piecol/MIRA/nextpcb/MIRA_BOM_1.xlsx

Designator | MPN | Quantity | Value | Footprint | LCSC | Manufacturer | Description | Product link
L8 | LQW15AN68NG00D | 1 | 68nH | Inductor_SMD:L_0402_1005Metric | C108965 | Murata Electronics | 1.96Ω 140mA 68nH Unshielded Inductor ±2% 0402 Power Inductors ROHS | https://jlcpcb.com/partdetail/MurataElectronics-LQW15AN68NG00D/C108965
L9 | LQW15AN9N1G00D | 1 | 9.1nH | Inductor_SMD:L_0402_1005Metric | C113122 | Murata Electronics | 140mΩ 25@250MHz 5.5GHz 540mA 9.1nH ±2% 0402 Inductors (SMD) ROHS | https://jlcpcb.com/partdetail/MurataElectronics-LQW15AN9N1G00D/C113122
R7,R11,R12,R21,R35,R36 | 0402WGF1001TCE | 6 | 1k | Resistor_SMD:R_0402_1005Metric | C11702 | UNI-ROYAL(Uniroyal Elec) | -55℃~+155℃ 1kΩ 50V 62.5mW Thick Film Resistor ±1% ±100ppm/℃ 0402 Chip Resistor - Surface Mount ROHS | https://jlcpcb.com/partdetail/12256-0402WGF1001TCE/C11702
U10 | RFANT3216120A5T | 1 | RFANT3216120A5T | EasyEDA:FILTER-SMD_1206-2P-L3.2-W1.6-L | C127629 | Walsin Tech Corp | -40℃~+85℃ 1.2mm 1.55mm 1.6mm 100MHz 2 2.4GHz 2dBi 3.2mm 1206 Antennas ROHS | https://jlcpcb.com/partdetail/Walsin_TechCorp-RFANT3216120A5T/C127629
Q1 | AO3401A | 1 | AO3401A | Package_TO_SOT_SMD:SOT-23 | C15127 | Alpha & Omega Semicon | 1 P-Channel 14nC@10V 30V 47mΩ@10V、60mΩ@4.5V、85mΩ@2.5V 4A 55pF 645pF 80pF 900mV SOT-23 MOSFETs ROHS | https://jlcpcb.com/partdetail/Alpha_OmegaSemicon-AO3401A/C15127
U11 | LIS3DHTR | 1 | LIS3DH | Package_LGA:LGA-16_3x3mm_P0.5mm_LayoutBorder3x5y | C15134 | STMicroelectronics | -40℃~+85℃ 1.71V~3.6V 16bit 500nA Accelerometer Motion event detection SPI、I2C X,Y,Z ±16g LGA-16(3x3) Accelerometers ROHS | https://jlcpcb.com/partdetail/STMicroelectronics-LIS3DHTR/C15134
Q2,Q4 | DMN2990UFA-7B | 2 | DMN2990UFA-7B | EasyEDA:XFDFN-3_L0.8-W0.6-P0.35-BR | C151598 | Diodes Incorporated | -55℃~+150℃ 1 N-channel 1V 2.4Ω@1.5V 20V 400mW 5.6pF 510mA 55.2pF 8pF N-Channel XFDFN-3(0.6x0.8) MOSFETs ROHS | https://jlcpcb.com/partdetail/DiodesIncorporated-DMN2990UFA7B/C151598
U2 | TPS63900DSKR | 1 | TPS63900 | Package_SON:WSON-10-1EP_2.5x2.5mm_P0.5mm_EP1.2x2mm_ThermalVias | C1518762 | Texas Instruments | -40℃~+125℃@(TJ) 1 1.8V~5.5V 1.8V~5V 400mA 75nA Adjustable Buck-Boost Buck-Boost Built-in Overcurrent Protection、Adjustable current limiting、Dynamic voltage scaling Yes WSON-10-EP(2.5x2.5) DC-DC Converters ROHS | https://jlcpcb.com/partdetail/TexasInstruments-TPS63900DSKR/C1518762
C47 | CL05B103KB5NNNC | 1 | 10n | Capacitor_SMD:C_0402_1005Metric | C15195 | Samsung Electro-Mechanics | 10nF 50V X7R ±10% 0402 Multilayer Ceramic Capacitors MLCC - SMD/SMT ROHS | https://jlcpcb.com/partdetail/15869-CL05B103KB5NNNC/C15195
C3,C5,C28,C32,C34,C36,C39,C44,C45,C46 | CL05B104KO5NNNC | 10 | 100n | Capacitor_SMD:C_0402_1005Metric | C1525 | Samsung Electro-Mechanics | 100nF 16V X7R ±10% 0402 Multilayer Ceramic Capacitors MLCC - SMD/SMT ROHS | https://jlcpcb.com/partdetail/1877-CL05B104KO5NNNC/C1525
C27 | 0402CG150J500NT | 1 | 15p | Capacitor_SMD:C_0402_1005Metric | C1548 | FH (Guangdong Fenghua Advanced Tech) | 15pF 50V C0G ±5% 0402 Multilayer Ceramic Capacitors MLCC - SMD/SMT ROHS | https://jlcpcb.com/partdetail/1900-0402CG150J500NT/C1548
C6,C7,C12,C30,C50 | CL05A106MQ5NUNC | 5 | 10u | Capacitor_SMD:C_0402_1005Metric | C15525 | Samsung Electro-Mechanics | 10uF 6.3V X5R ±20% 0402 Multilayer Ceramic Capacitors MLCC - SMD/SMT ROHS | https://jlcpcb.com/partdetail/16204-CL05A106MQ5NUNC/C15525
C35,C37 | 0402CG390J500NT | 2 | 39p | Capacitor_SMD:C_0402_1005Metric | C1563 | FH (Guangdong Fenghua Advanced Tech) | 39pF 50V C0G ±5% 0402 Multilayer Ceramic Capacitors MLCC - SMD/SMT ROHS | https://jlcpcb.com/partdetail/1915-0402CG390J500NT/C1563
C21 | GRM0335C1E180GA01D | 1 | 18p | Capacitor_SMD:C_0201_0603Metric | C161374 | Murata Electronics | 18pF 25V C0G ±2% 0201 Multilayer Ceramic Capacitors MLCC - SMD/SMT ROHS | https://jlcpcb.com/partdetail/172755-GRM0335C1E180GA01D/C161374
C29 | CL21A476MQYNNNE | 1 | 47u | Capacitor_SMD:C_0805_2012Metric | C16780 | Samsung Electro-Mechanics | 47uF 6.3V X5R ±20% 0805 Multilayer Ceramic Capacitors MLCC - SMD/SMT ROHS | https://jlcpcb.com/partdetail/17464-CL21A476MQYNNNE/C16780
R5,R10,R28,R37,R38,R39 | 0402WGF0000TCE | 6 | 0R | Resistor_SMD:R_0402_1005Metric | C17168 | UNI-ROYAL(Uniroyal Elec) | -55℃~+155℃ 0Ω 50V 62.5mW Thick Film Resistor ±1% ±800ppm/℃ 0402 Chip Resistor - Surface Mount ROHS | https://jlcpcb.com/partdetail/17853-0402WGF0000TCE/C17168
D1,D2,D5 | 1N5819WS | 3 | 1N5819WS | Diode_SMD:D_SOD-323 | C191023 | Guangdong Hottech | 1 Independent 1A 25A 40V 500uA@40V 600mV@1A SOD-323 Schottky Diodes ROHS | https://jlcpcb.com/partdetail/GuangdongHottech-1N5819WS/C191023
U14 | SHTC3-TR-2.5KS | 1 | SHTC3 | Sensor_Humidity:Sensirion_DFN-4-1EP_2x2mm_P1mm_EP0.7x1.6mm | C194656 | Sensirion | -40℃~+125℃ 0%RH~100%RH 1.62V~3.6V 16bit 430uA Factory calibration、Temperature compensation I2C ±0.2℃ ±2%RH DFN-4-EP(2x2) Temperature and Humidity Sensor ROHS | https://jlcpcb.com/partdetail/Sensirion-SHTC3_TR_25KS/C194656
C31,C33 | CL10A475KO8NNNC | 2 | 4.7u | Capacitor_SMD:C_0603_1608Metric | C19666 | Samsung Electro-Mechanics | 16V 4.7uF X5R ±10% 0603 Multilayer Ceramic Capacitors MLCC - SMD/SMT ROHS | https://jlcpcb.com/partdetail/20375-CL10A475KO8NNNC/C19666
U6 | BQ25185DLHR | 1 | BQ25185DLHR | EasyEDA:WSON-10_L2.2-W2.0-P0.40-BL-EP_TI_DLH0010A | C19725033 | Texas Instruments | -40℃~+125℃ 1 1A 2.2V 3V~18V 4.4V 4uA Charging IC Lithium Battery、LiFePO4 Battery Support WSON-10-EP(2.2x2) Battery Management ROHS | https://jlcpcb.com/partdetail/TexasInstruments-BQ25185DLHR/C19725033
L4,L5 | LQP03TN3N5B02D | 2 | 3.5nH | Inductor_SMD:L_0201_0603Metric | C206424 | Murata Electronics | 14@500MHz 250mΩ 3.5nH 450mA 7GHz Thick Film Inductor 0201 Inductors (SMD) ROHS | https://jlcpcb.com/partdetail/MurataElectronics-LQP03TN3N5B02D/C206424
D3,D6,D7,D8,D9 | XL-1005UBC | 5 | XL-1005UBC_C22355736 | LED_SMD:LED_0402_1005Metric | C22355736 | XINGLIGHT | -40℃~+85℃ 120° 20mA 240mcd 3.3V 455nm~475nm 465nm 70mW Blue Discrete Diode Top-mount Water Clear 0402 LED Indication - Discrete ROHS | https://jlcpcb.com/partdetail/XINGLIGHT-XL1005UBC/C22355736
U8 | nRF9151-LACA-R7 | 1 | nRF9151-LAXX | PCM_nordic-lib-kicad-nrf9:LGA_9151_12.1x11.1mm | C22397843 | Nordic Semicon | LGA-113(12.1x11.1) RF Modules ROHS | https://jlcpcb.com/partdetail/NordicSemicon-nRF9151_LACAR7/C22397843
J2,J3 | CONUFL001-SMD-T | 2 | Conn_Coaxial_Small | Connector_Coaxial:U.FL_Molex_MCRF_73412-0110_Vertical | C22418213 | TE Connectivity | -40℃~+90℃ 1 50Ω 6GHz Board Side Male Pin SMD Coaxial Connectors (RF) ROHS | https://jlcpcb.com/partdetail/TEConnectivity-CONUFL001_SMDT/C22418213
R22 | 0402WGF470KTCE | 1 | 4.7R | Resistor_SMD:R_0402_1005Metric | C25121 | UNI-ROYAL(Uniroyal Elec) | -55℃~+155℃ 4.7Ω 50V 62.5mW Thick Film Resistor ±1% ±200ppm/℃ 0402 Chip Resistor - Surface Mount ROHS | https://jlcpcb.com/partdetail/25864-0402WGF470KTCE/C25121
R30,R32,R33 | 0402WGF1003TCE | 3 | 100k | Resistor_SMD:R_0402_1005Metric | C25741 | UNI-ROYAL(Uniroyal Elec) | -55℃~+155℃ 100kΩ 50V 62.5mW Thick Film Resistor ±1% ±100ppm/℃ 0402 Chip Resistor - Surface Mount ROHS | https://jlcpcb.com/partdetail/26484-0402WGF1003TCE/C25741
R8,R16,R19,R40 | 0402WGF1002TCE | 4 | 10k | Resistor_SMD:R_0402_1005Metric | C25744 | UNI-ROYAL(Uniroyal Elec) | -55℃~+155℃ 10kΩ 50V 62.5mW Thick Film Resistor ±1% ±100ppm/℃ 0402 Chip Resistor - Surface Mount ROHS | https://jlcpcb.com/partdetail/26487-0402WGF1002TCE/C25744
R42 | 0402WGF3303TCE | 1 | 330k | Resistor_SMD:R_0402_1005Metric | C25778 | UNI-ROYAL(Uniroyal Elec) | -55℃~+155℃ 330kΩ 50V 62.5mW Thick Film Resistor ±1% ±100ppm/℃ 0402 Chip Resistor - Surface Mount ROHS | https://jlcpcb.com/partdetail/26521-0402WGF3303TCE/C25778
R6 | 0402WGF3652TCE | 1 | 36.5K | Resistor_SMD:R_0402_1005Metric | C25887 | UNI-ROYAL(Uniroyal Elec) | -55℃~+155℃ 36.5kΩ 50V 62.5mW Thick Film Resistor ±1% ±100ppm/℃ 0402 Chip Resistor - Surface Mount ROHS | https://jlcpcb.com/partdetail/26630-0402WGF3652TCE/C25887
R18,R20,R23,R24,R25,R26,R27 | 0402WGF4701TCE | 7 | 4.7k | Resistor_SMD:R_0402_1005Metric | C25900 | UNI-ROYAL(Uniroyal Elec) | -55℃~+155℃ 4.7kΩ 50V 62.5mW Thick Film Resistor ±1% ±100ppm/℃ 0402 Chip Resistor - Surface Mount ROHS | https://jlcpcb.com/partdetail/26643-0402WGF4701TCE/C25900
R2,R3,R13 | 0402WGF5101TCE | 3 | 5.1k | Resistor_SMD:R_0402_1005Metric | C25905 | UNI-ROYAL(Uniroyal Elec) | -55℃~+155℃ 5.1kΩ 50V 62.5mW Thick Film Resistor ±1% ±100ppm/℃ 0402 Chip Resistor - Surface Mount ROHS | https://jlcpcb.com/partdetail/26648-0402WGF5101TCE/C25905
R1,R29,R31,R34,R41 | 0402WGF1004TCE | 5 | 1M | Resistor_SMD:R_0402_1005Metric | C26083 | UNI-ROYAL(Uniroyal Elec) | -55℃~+155℃ 1MΩ 50V 62.5mW Thick Film Resistor ±1% ±100ppm/℃ 0402 Chip Resistor - Surface Mount ROHS | https://jlcpcb.com/partdetail/26826-0402WGF1004TCE/C26083
U9 | SKY65943-11 | 1 | SKY65943-11 | EasyEDA:MCM-10_L2.5-W2.5-P0.50-BL-EP | C2654442 | Skyworks Solutions | -40℃~+85℃ 1.559GHz~1.606GHz GPS、Galileo、GLONASS、GNSS Integrated low noise amplifier、Integrated RF filter MCM-10(2.5x2.5) RF Front End Circuits ROHS | https://jlcpcb.com/partdetail/SkyworksSolutions-SKY6594311/C2654442
U4,U5 | TPS22917DBVR | 2 | TPS22917DBV | Package_TO_SOT_SMD:SOT-23-6 | C2681320 | Texas Instruments | -40℃~+125℃ 0V~5.5V 1 2A 80mΩ Active High Load Switch SOT-23-6 Power Distribution Switches ROHS | https://jlcpcb.com/partdetail/TexasInstruments-TPS22917DBVR/C2681320
U1 | TPUSBLC6-2P6 | 1 | USBLC6-2P6 | EasyEDA:SOT-666-6_L1.6-W1.2-P0.50-LS1.6-BL | C2682291 | TECH PUBLIC | -55℃~+125℃ 0.8pF 100W@8/20us 16V 5A@8/20us 5V 6.5V 80nA IEC 61000-4-2、IEC 61000-4-5、IEC 61000-4-4 SOT-666-6 ESD and Surge Protection (TVS/ESD) ROHS | https://jlcpcb.com/partdetail/TECHPUBLIC-TPUSBLC62P6/C2682291
R4 | 0402WGF1622TCE | 1 | 16.2k | Resistor_SMD:R_0402_1005Metric | C27176 | UNI-ROYAL(Uniroyal Elec) | -55℃~+155℃ 16.2kΩ 50V 62.5mW Thick Film Resistor ±1% ±100ppm/℃ 0402 Chip Resistor - Surface Mount ROHS | https://jlcpcb.com/partdetail/27925-0402WGF1622TCE/C27176
L11 | TPD3F303DQDR | 1 | TPD3F303DQDR | EasyEDA:WSON-8_L1.7-W1.4-P0.40-BL-EP | C2869050 | Texas Instruments | -40℃~+85℃ 2 20pF 3 308MHz 47Ω、100Ω Yes WSON-8-EP(1.4x1.7) EMI/RFI Filters (LC, RC Networks) ROHS | https://jlcpcb.com/partdetail/TexasInstruments-TPD3F303DQDR/C2869050
USB1 | HC-TYPE-C-16P-01M | 1 | HC-TYPE-C-16P-01M | EasyEDA:USB-C-SMD_HCTL_HC-TYPE-C-16P-01M | C2894899 | HCTL | -30℃~+85℃ 1 10000 times 100V 16P 5A Black Female Surface Mount, Right Angle Type-C SMD USB Connectors ROHS | https://jlcpcb.com/partdetail/HCTL-HC_TYPE_C_16P01M/C2894899
J4 | SF72S006VBDR2500 | 1 | JAE_SIM_Card_SF72S006 | Connector_JAE:JAE_SIM_Card_SF72S006 | C2977286 | JAE Electronics | -25℃~+85℃ 1.25mm 10V Connector and Ejector Nano-SIM Card Push-Push SMD SIM Card Connectors ROHS | https://jlcpcb.com/partdetail/JAEElectronics-SF72S006VBDR2500/C2977286
Q3 | DMP22D4UFA-7B | 1 | DMP22D4UFA-7B | EasyEDA:X2-DFN0806-3_L0.8-W0.6-P0.35-BR | C2983692 | Diodes Incorporated | -55℃~+150℃ 1 P-Channel 1V 2.9pF 20V 28.7pF 330mA 400mW 400pC@4.5V 5Ω@1.5V P-Channel X2-DFN0806-3 MOSFETs ROHS | https://jlcpcb.com/partdetail/DiodesIncorporated-DMP22D4UFA7B/C2983692
U16 | APHF1608LSEEQBDZGKC | 1 | APHF1608LSEEQBDZGKC | EasyEDA:LED-SMD_4P-L1.6-W0.8_APHF1608LSEEQBDZGKC | C3019171 | Kingbright | -40℃~+85℃ 0.5mm 0.8mm 1.6mm 140° B:10mcd、G:90mcd、R:15mcd B:460nm、R:630nm、G:515nm Common Anode G:20mA、B:20mA、R:30mA G:525nm、R:621nm、B:465nm R:1.8V~2.1V、G:2.65V~3.1V、B:2.65V~3.1V R:3000V、G:450V、B:250V R:75mW、B:80mW、G:82mW Water Clear SMD-4P,1.6x0.8mm RGB LEDs ROHS | https://jlcpcb.com/partdetail/Kingbright-APHF1608LSEEQBDZGKC/C3019171
L1 | XAL4020-222MEC | 1 | 2.2 uH | Inductor_SMD:L_Coilcraft_XxL4020 | C3151182 | Coilcraft | 2.2uH 35.2mΩ 5.5A 5.6A ±20% SMD,4x4mm Power Inductors ROHS | https://jlcpcb.com/partdetail/Coilcraft-XAL4020222MEC/C3151182
C18,C22 | CL03A225MP3CRNC | 2 | 2.2u | Capacitor_SMD:C_0201_0603Metric | C318539 | Samsung Electro-Mechanics | 10V 2.2uF X5R ±20% 0201 Multilayer Ceramic Capacitors MLCC - SMD/SMT ROHS | https://jlcpcb.com/partdetail/299668-CL03A225MP3CRNC/C318539
U7 | NRF54L15-QFAA-R | 1 | nRF54L15-QFXX | Package_DFN_QFN:QFN-48-1EP_6x6mm_P0.4mm_EP4.6x4.6mm | C42458750 | Nordic Semicon | Power-on reset (POR)、Undervoltage detection (BOR/LVD/LVR/LVI)、Watchdog reset、Software reset、External pin reset (NRST)、Built-in general-purpose timer、Calendar function、Built-in temperature sensor QFN-48(6x6) Microcontrollers (MCU/MPU/SOC) ROHS | https://jlcpcb.com/partdetail/NordicSemicon-NRF54L15_QFAAR/C42458750
CN3,CN4 | 1.25T-2P立贴 | 2 | 1.25mm-2P socket | EasyEDA:CONN-SMD_1.25T-2P | C43462 | BOOMELE(Boom Precision Elec) | -25℃~+85℃ 1 1.25mm 125V 1A 1x2P 2 2P 3.7mm 4.75mm Beige PicoBlade(MX 1.25) Surface Mount,Vertical SMD,P=1.25mm Wire To Board Connector ROHS | https://jlcpcb.com/partdetail/BOOMELE_Boom_Precision_Elec-1_25T_2P/C43462
CN1,CN2 | FTSH-105-01-L-DV-K-TR | 2 | FTSH-105 | EasyEDA:CONN-SMD_FTSH-105-01-L-DV-K-TR | C448647 | Samtec | -55℃~+125℃ 1.27mm 10P 2 3.4A Phosphor bronze Surface Mount,Vertical SMD,P=1.27mm Board-to-Board and Backplane Connector ROHS | https://jlcpcb.com/partdetail/Samtec-FTSH_105_01_L_DV_KTR/C448647
C4,C49 | CL21A226MAQNNNE | 2 | 22u | Capacitor_SMD:C_0805_2012Metric | C45783 | Samsung Electro-Mechanics | 22uF 25V X5R ±20% 0805 Multilayer Ceramic Capacitors MLCC - SMD/SMT ROHS | https://jlcpcb.com/partdetail/46786-CL21A226MAQNNNE/C45783
C13,C14,C16,C19,C48 | CL03A104KP3NNNC | 5 | 100n | Capacitor_SMD:C_0201_0603Metric | C49062 | Samsung Electro-Mechanics | 100nF 10V X5R ±10% 0201 Multilayer Ceramic Capacitors MLCC - SMD/SMT ROHS | https://jlcpcb.com/partdetail/50070-CL03A104KP3NNNC/C49062
R9 | 0402WGF6200TCE | 1 | 600R | Resistor_SMD:R_0402_1005Metric | C4961 | UNI-ROYAL(Uniroyal Elec) | -55℃~+155℃ 50V 62.5mW 620Ω Thick Film Resistor ±1% ±100ppm/℃ 0402 Chip Resistor - Surface Mount ROHS | https://jlcpcb.com/partdetail/5369-0402WGF6200TCE/C4961
D4 | BZT52B6V2 | 1 | BZT52Bxx | Diode_SMD:D_SOD-123F | C52148463 | YTL | SOD-123 Zener Diodes ROHS | https://jlcpcb.com/partdetail/YTL-BZT52B6V2/C52148463
C51,C52 | CL05A105KA5NQNC | 2 | 1u | Capacitor_SMD:C_0402_1005Metric | C52923 | Samsung Electro-Mechanics | 1uF 25V X5R ±10% 0402 Multilayer Ceramic Capacitors MLCC - SMD/SMT ROHS | https://jlcpcb.com/partdetail/53938-CL05A105KA5NQNC/C52923
X2 | ABS05-32.768KHZ-9-T | 1 | 32.768KHz | Crystal:Crystal_SMD_MicroCrystal_CM9V-T1A-2Pin_1.6x1.0mm | C596929 | Abracon LLC | -40℃~+85℃ 32.768kHz 90kΩ 9pF Crystal Oscillator ±20ppm SMD1610-2P Crystals ROHS | https://jlcpcb.com/partdetail/AbraconLLC-ABS05_32_768KHZ_9T/C596929
X1 | 7E032000F01 | 1 | 32MHz | EasyEDA:CRYSTAL-SMD_4P-L1.6-W1.2-BL | C655046 | HD | 32MHz 8pF Crystal Oscillator ±10ppm ±20ppm SMD1612-4P Crystals ROHS | https://jlcpcb.com/partdetail/HD-7E032000F01/C655046
C23 | GJM0335C1E2R0WB01D | 1 | 2p | Capacitor_SMD:C_0201_0603Metric | C668326 | Murata Electronics | 25V 2pF C0G 0201 Multilayer Ceramic Capacitors MLCC - SMD/SMT ROHS | https://jlcpcb.com/partdetail/698265-GJM0335C1E2R0WB01D/C668326
L3 | LQP03HQ2N7B02D | 1 | 2.7nH | Inductor_SMD:L_0201_0603Metric | C7216765 | Murata Electronics | 120mΩ 2.7nH 20@500MHz 600mA 9GHz Thick Film Inductor 0201 Inductors (SMD) ROHS | https://jlcpcb.com/partdetail/MurataElectronics-LQP03HQ2N7B02D/C7216765
U13,U15 | ZX-GH1.25-WT4 | 2 | ZX-GH1.25-WT4 | EasyEDA:CONN-SMD_4P-P1.25_ZX-GH1.25-WT4 | C7429517 | Megastar | -25℃~+85℃ 1 1.25mm 125V 1A 1x4P 4 4.35mm 4P 5mm 8.25mm Auxiliary Solder Pin Beige GH LCP Phosphor Bronze Surface Mount, Right Angle Tin SMD,P=1.25mm,卧贴 Wire To Board Connector ROHS | https://jlcpcb.com/partdetail/Megastar-ZX_GH1_25WT4/C7429517
U12 | ZX-GH1.25-WT6 | 1 | ZX-GH1.25-WT6 | EasyEDA:CONN-SMD_6P-P1.25_ZX-GH1.25-WT6 | C7429519 | Megastar | -25℃~+85℃ 1 1.25mm 10.75mm 125V 1A 1x6P 4.35mm 5mm 6 6P Auxiliary Solder Pin Beige Brass GH LCP Surface Mount, Right Angle Tin SMD,P=1.25mm,卧贴 Wire To Board Connector ROHS | https://jlcpcb.com/partdetail/Megastar-ZX_GH1_25WT6/C7429519
L2 | MLZ1608M4R7WT000 | 1 | 4.7uH | Inductor_SMD:L_0603_1608Metric | C76799 | TDK | 120mA 350mA 4.7uH 500mΩ Multilayer inductor ±20% 0603 Inductors (SMD) ROHS | https://jlcpcb.com/partdetail/TDK-MLZ1608M4R7WT000/C76799
C25 | GJM1555C1H1R5WB01D | 1 | 1.5p | Capacitor_SMD:C_0402_1005Metric | C76901 | Murata Electronics | 1.5pF 50V C0G 0402 Multilayer Ceramic Capacitors MLCC - SMD/SMT ROHS | https://jlcpcb.com/partdetail/MurataElectronics-GJM1555C1H1R5WB01D/C76901
C15,C38 | GRM0335C1E101JA01D | 2 | 100p | Capacitor_SMD:C_0201_0603Metric | C76917 | Murata Electronics | 100pF 25V C0G ±5% 0201 Multilayer Ceramic Capacitors MLCC - SMD/SMT ROHS | https://jlcpcb.com/partdetail/MurataElectronics-GRM0335C1E101JA01D/C76917
C17 | GRM0335C1H3R9CA01D | 1 | 3.9p | Capacitor_SMD:C_0201_0603Metric | C76926 | Murata Electronics | 3.9pF 50V C0G 0201 Multilayer Ceramic Capacitors MLCC - SMD/SMT ROHS | https://jlcpcb.com/partdetail/MurataElectronics-GRM0335C1H3R9CA01D/C76926
C24 | GRM0335C1HR30BA01D | 1 | 0.3p | Capacitor_SMD:C_0201_0603Metric | C76927 | Murata Electronics | 0.3pF 50V C0G 0201 Multilayer Ceramic Capacitors MLCC - SMD/SMT ROHS | https://jlcpcb.com/partdetail/MurataElectronics-GRM0335C1HR30BA01D/C76927
C9 | GRM1555C1H471JA01D | 1 | 470p | Capacitor_SMD:C_0402_1005Metric | C76971 | Murata Electronics | 470pF 50V C0G ±5% 0402 Multilayer Ceramic Capacitors MLCC - SMD/SMT ROHS | https://jlcpcb.com/partdetail/MurataElectronics-GRM1555C1H471JA01D/C76971
L6 | LQG15HS5N6S02D | 1 | 5.6nH | Inductor_SMD:L_0402_1005Metric | C85670 | Murata Electronics | 200mΩ 4.5GHz 5.6nH 650mA 8@100MHz Multilayer inductor 0402 Inductors (SMD) ROHS | https://jlcpcb.com/partdetail/MurataElectronics-LQG15HS5N6S02D/C85670
C20 | GRM0335C1H1R5WA01D | 1 | 1.5p | Capacitor_SMD:C_0201_0603Metric | C88913 | Murata Electronics | 1.5pF 50V C0G 0201 Multilayer Ceramic Capacitors MLCC - SMD/SMT ROHS | https://jlcpcb.com/partdetail/MurataElectronics-GRM0335C1H1R5WA01D/C88913
L7,L10 | BLM15PX121SN1D | 2 | BLM15PX121SN1D | Inductor_SMD:L_0402_1005Metric | C88970 | Murata Electronics | -55℃~+125℃ 1 120Ω@100MHz 2A 55mΩ ±25% 0402 Ferrite Beads ROHS | https://jlcpcb.com/partdetail/MurataElectronics-BLM15PX121SN1D/C88970
FB1,FB2 | BLM03AG121SN1D | 2 | 120 | Inductor_SMD:L_0201_0603Metric | C97850 | Murata Electronics | -55℃~+125℃ 1 120Ω@100MHz 200mA 500mΩ ±25% 0201 Ferrite Beads ROHS | https://jlcpcb.com/partdetail/MurataElectronics-BLM03AG121SN1D/C97850
U3 | CH340E | 1 | CH340E | Package_SO:MSOP-10_3x3mm_P0.5mm | C99652 | WCH(Jiangsu Qin Heng) | 150uA 20mA 2Mbps 3.3V、5V Transceiver USB 2.0 MSOP-10 USB Converters ROHS | https://jlcpcb.com/partdetail/WCH_Jiangsu_Qin_Heng-CH340E/C99652
