piecol/MIRA/MIRA.pdf

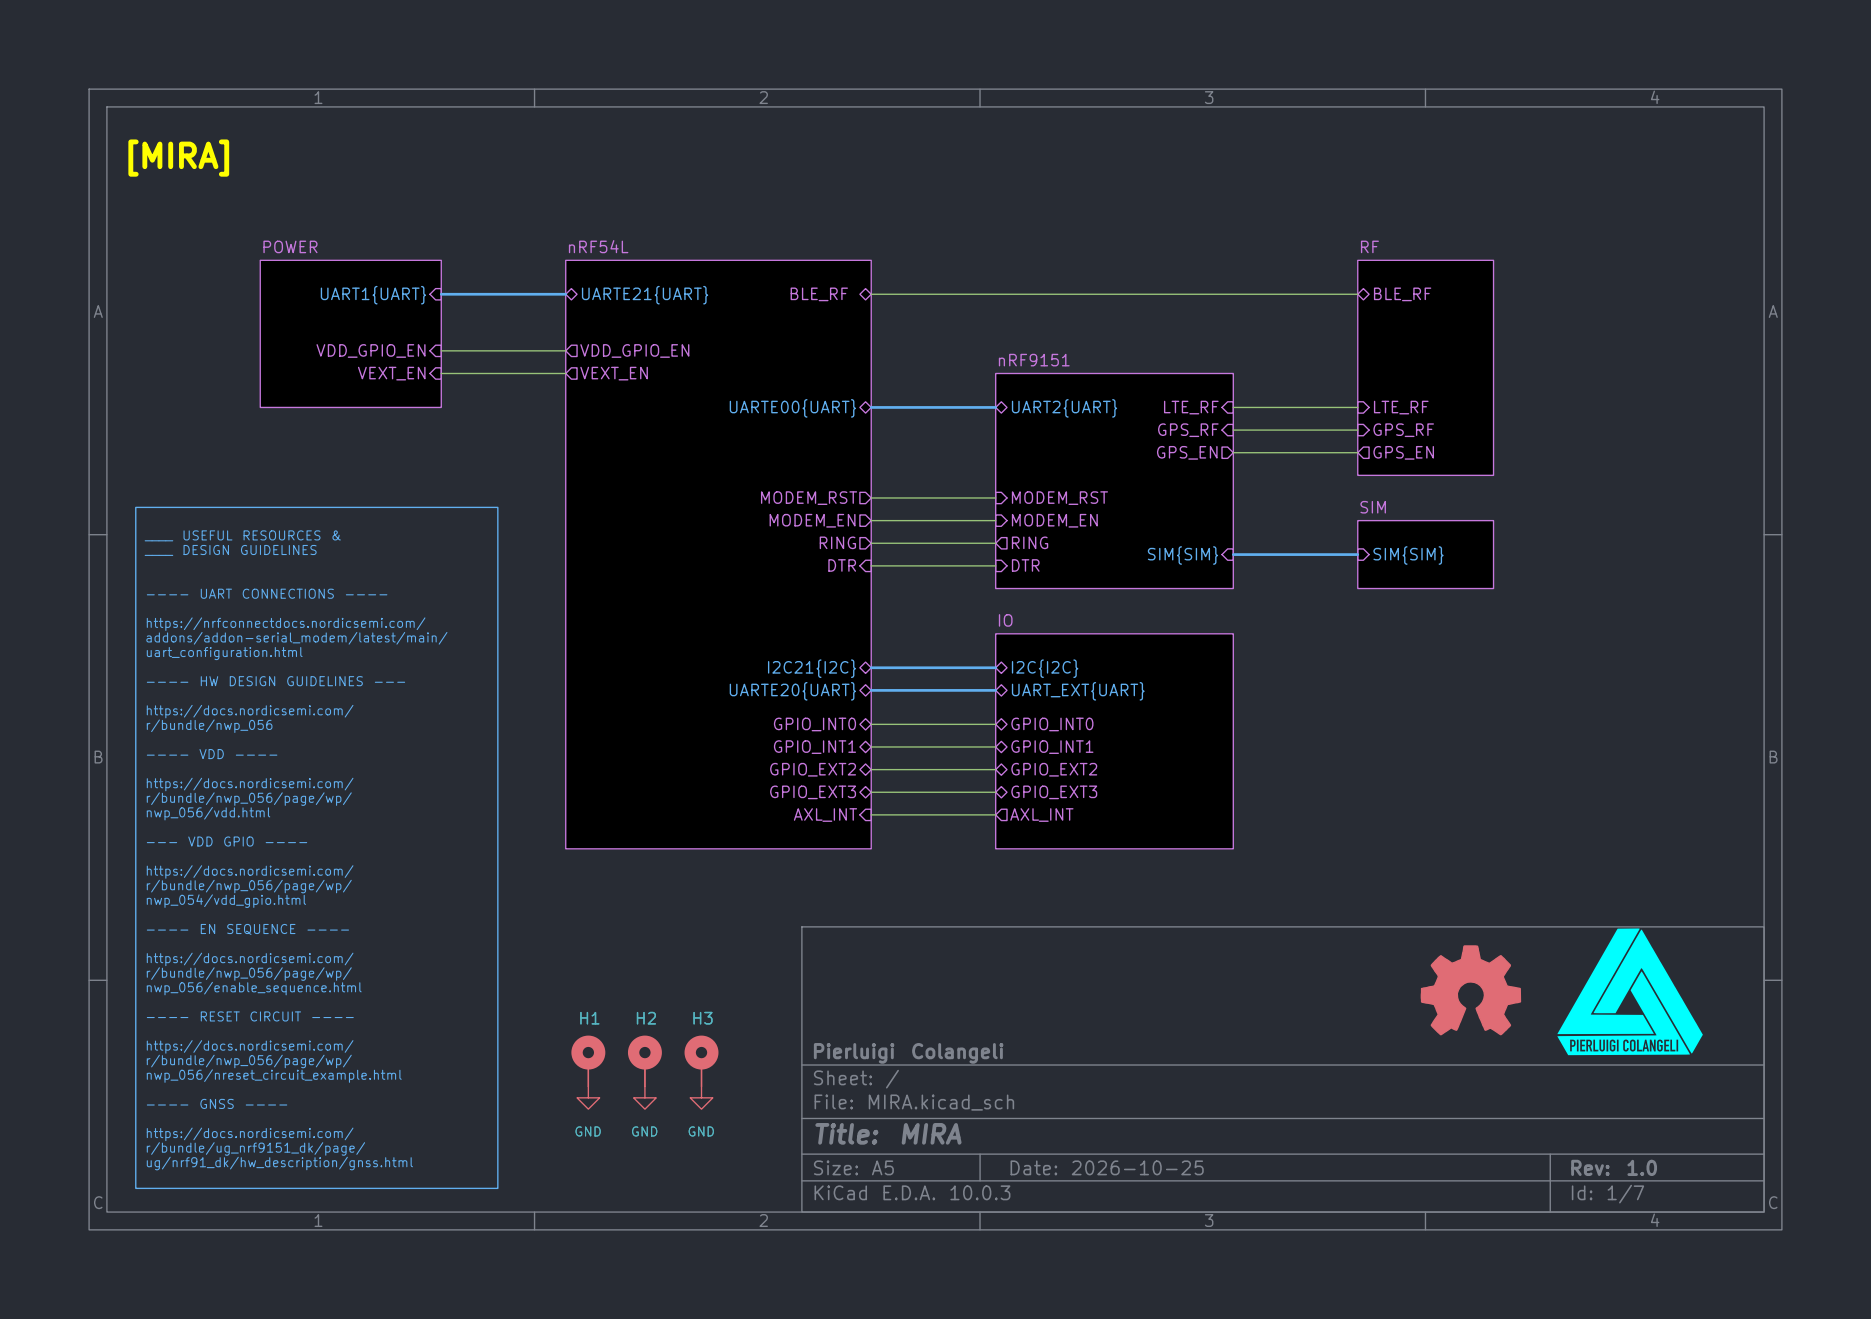
[picture p1: page 1]

ug/nrf91_dk/hw_description/gnss.html [MIRA]

____ USEFUL RESOURCES &
____ DESIGN GUIDELINES ---- UART CONNECTIONS ----

https://nrfconnectdocs.nordicsemi.com/
addons/addon-serial_modem/latest/main/
uart_configuration.html ---- HW DESIGN GUIDELINES ---

https://docs.nordicsemi.com/
r/bundle/nwp_056 ---- VDD ----

r/bundle/nwp_056/page/wp/
nwp_056/vdd.html --- VDD GPIO ----

nwp_054/vdd_gpio.html ---- EN SEQUENCE ----

nwp_056/enable_sequence.html ---- RESET CIRCUIT ----

nwp_056/nreset_circuit_example.html ---- GNSS ----

r/bundle/ug_nrf9151_dk/page/

Size: A5 | Rev: 1.0 | C Date: 2026-10-25
KiCad E.D.A. 10.0.3 | Id: 1/7

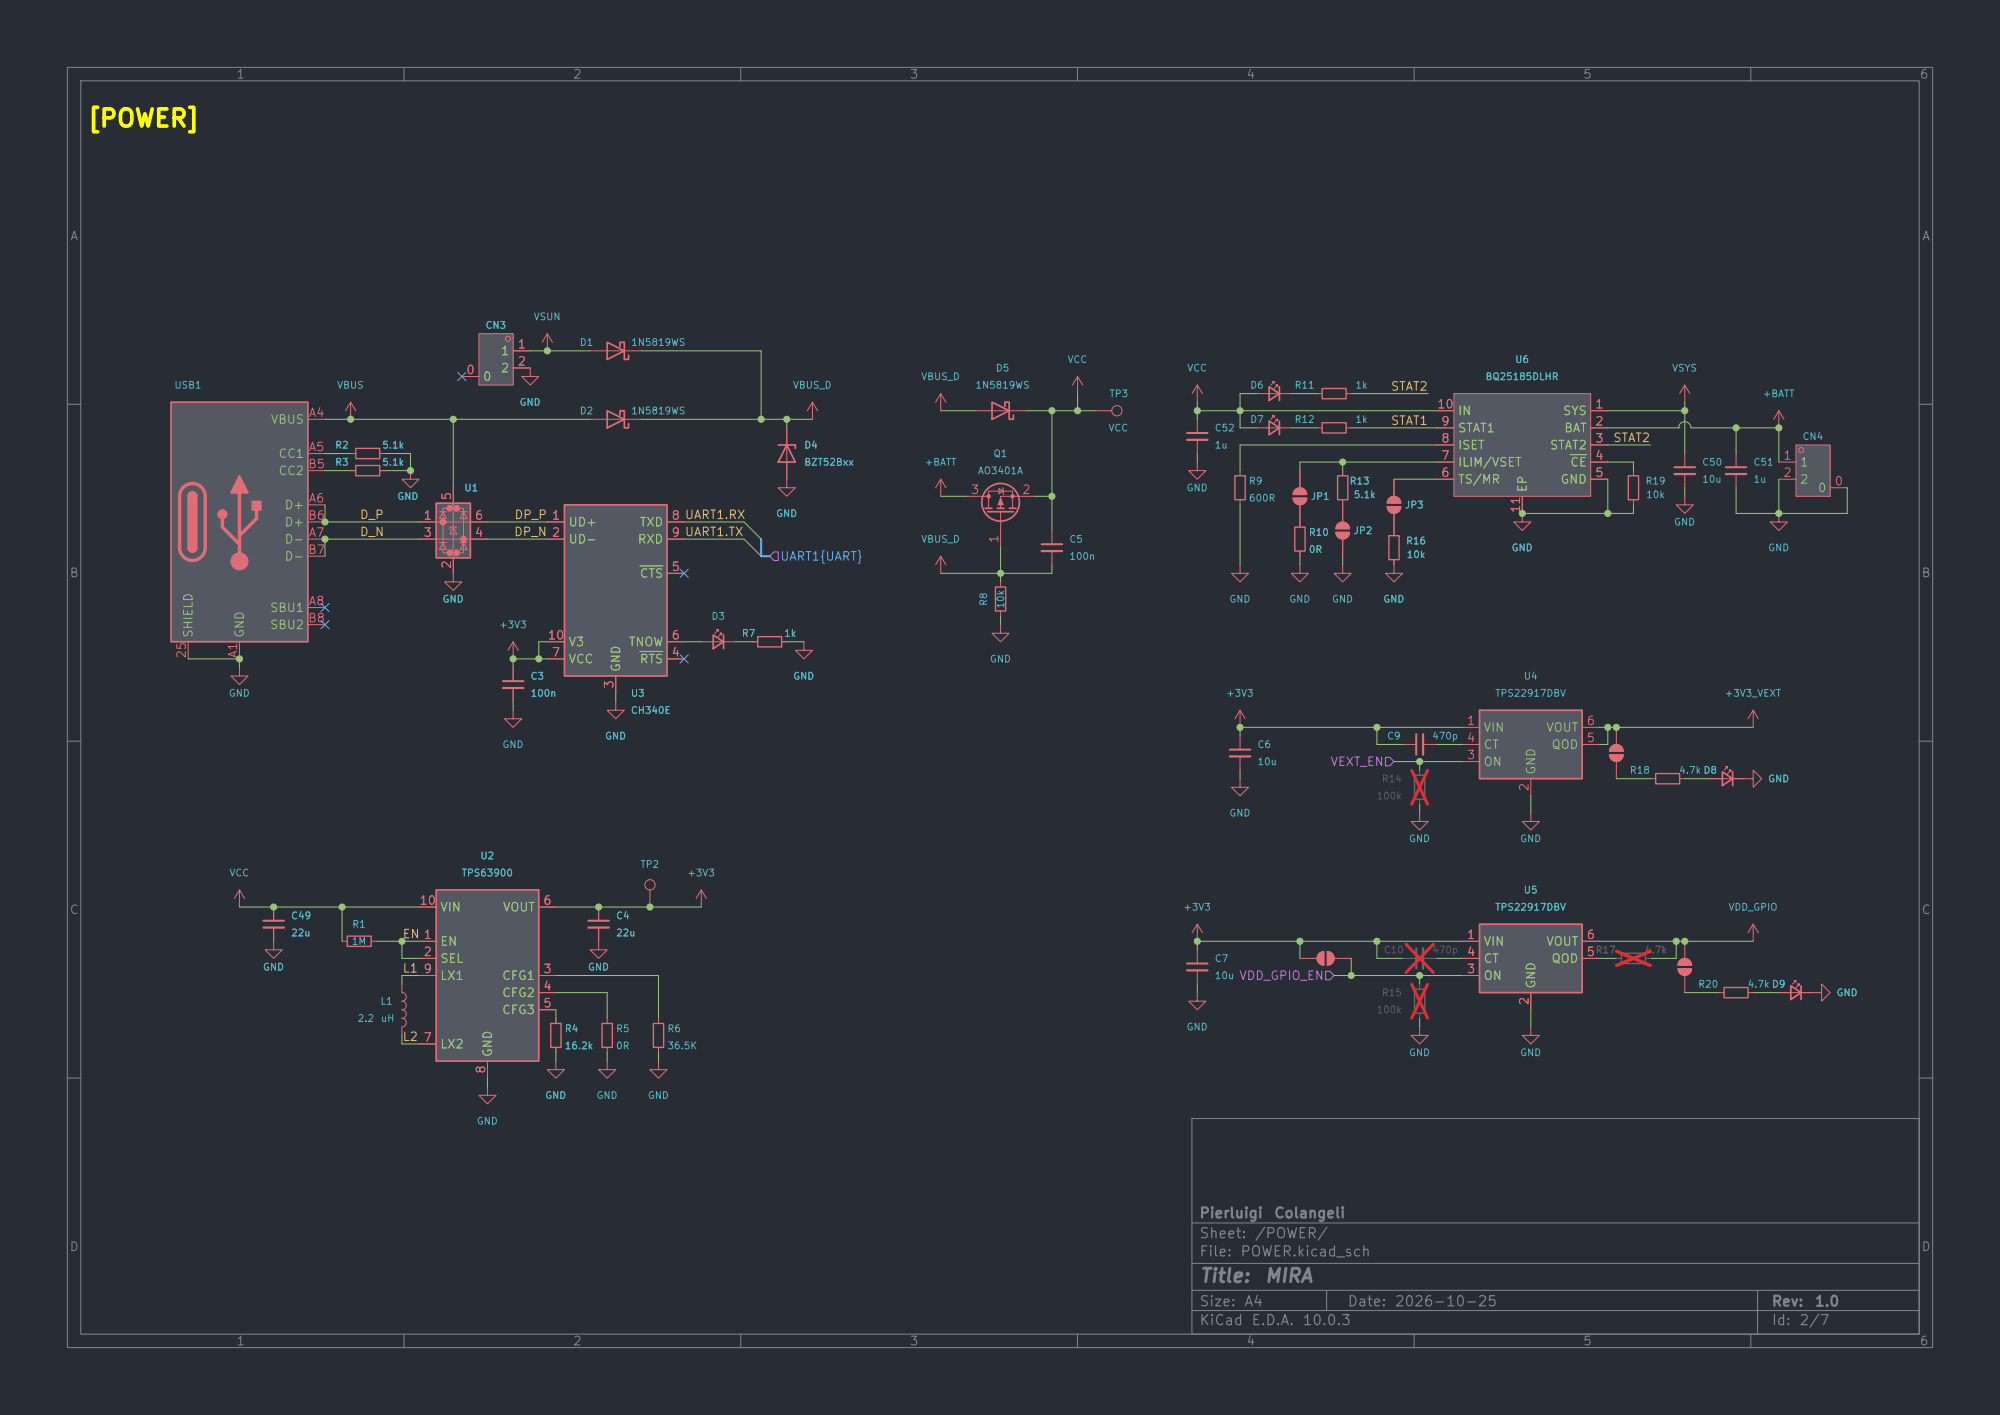
[picture p2: page 2]

Size: A4 | Rev: 1.0
KiCad E.D.A. 10.0.3 | Id: 2/7

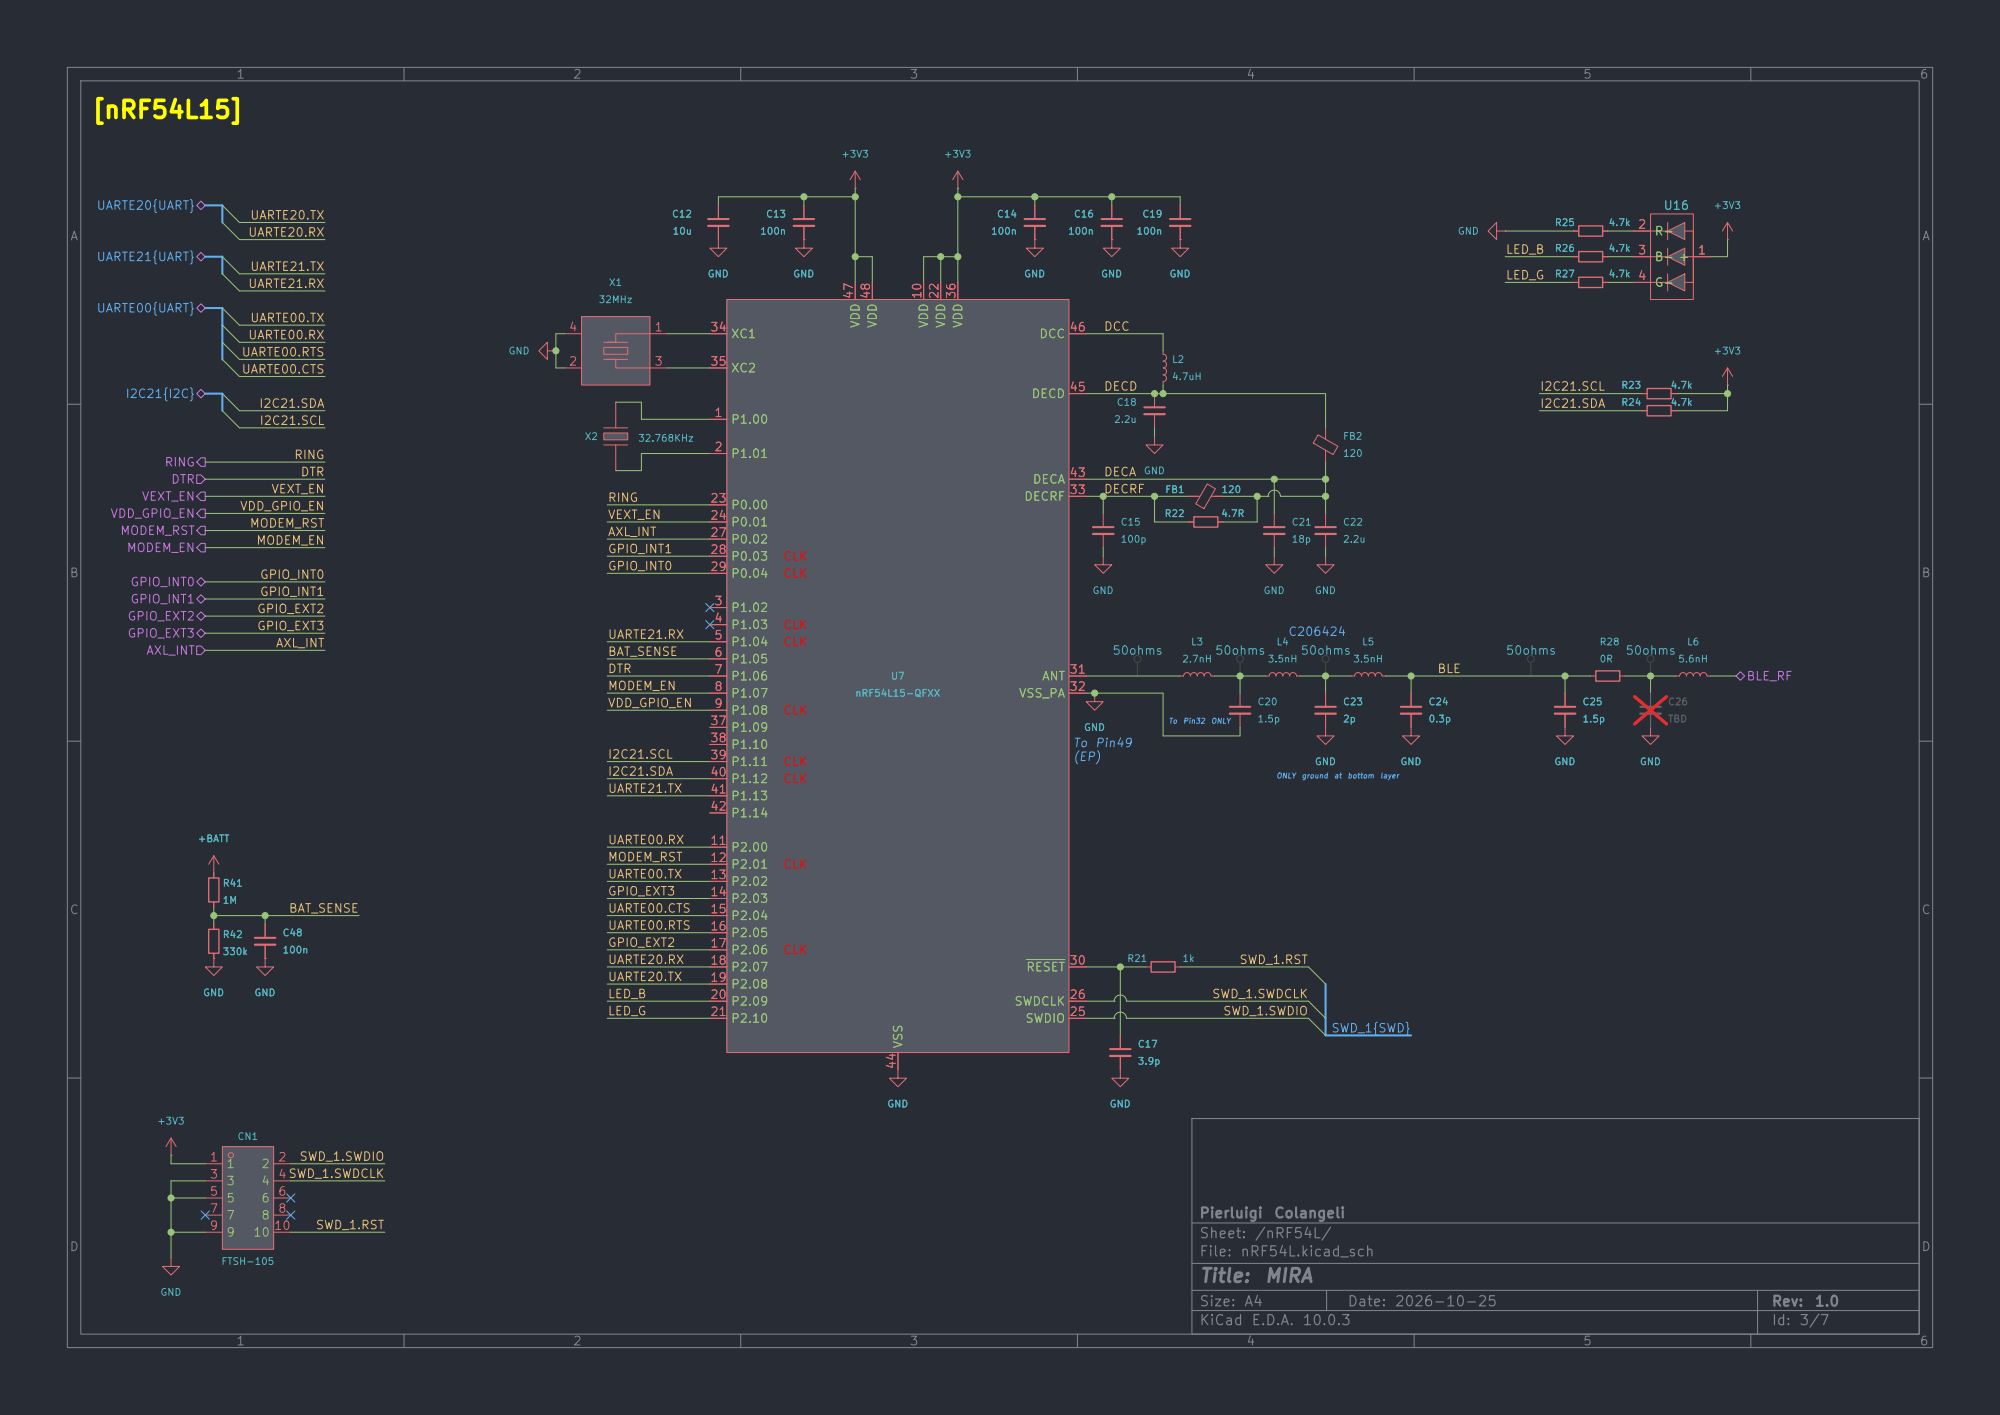
[picture p3: page 3]

ONLY ground at bottom layer To Pin32 ONLY R41

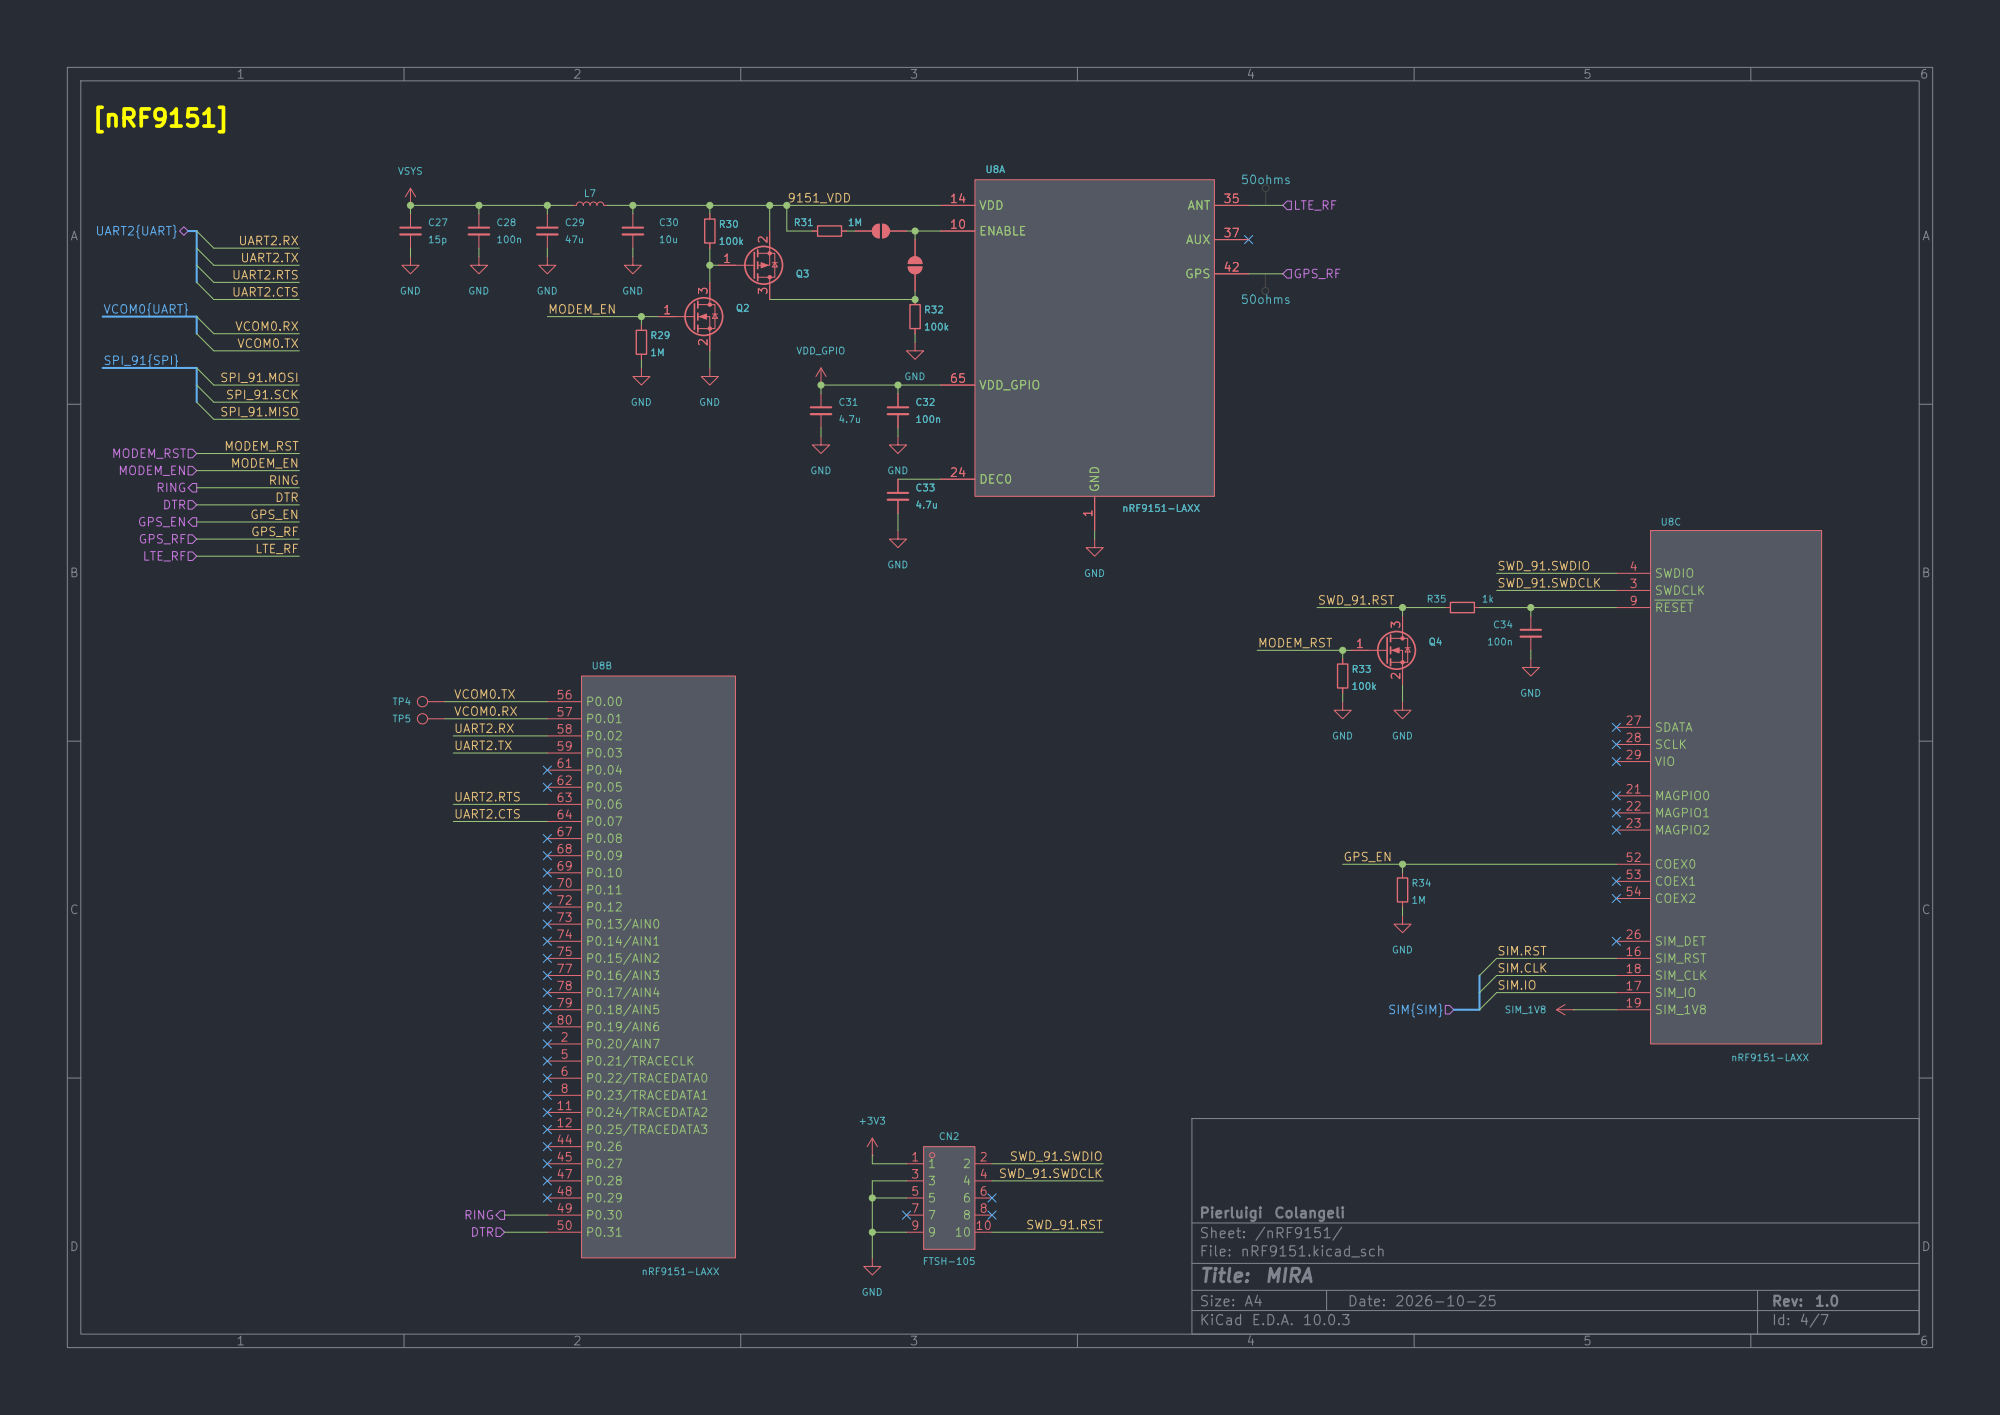
[picture p4: page 4]

SIM.RST SIM.IO

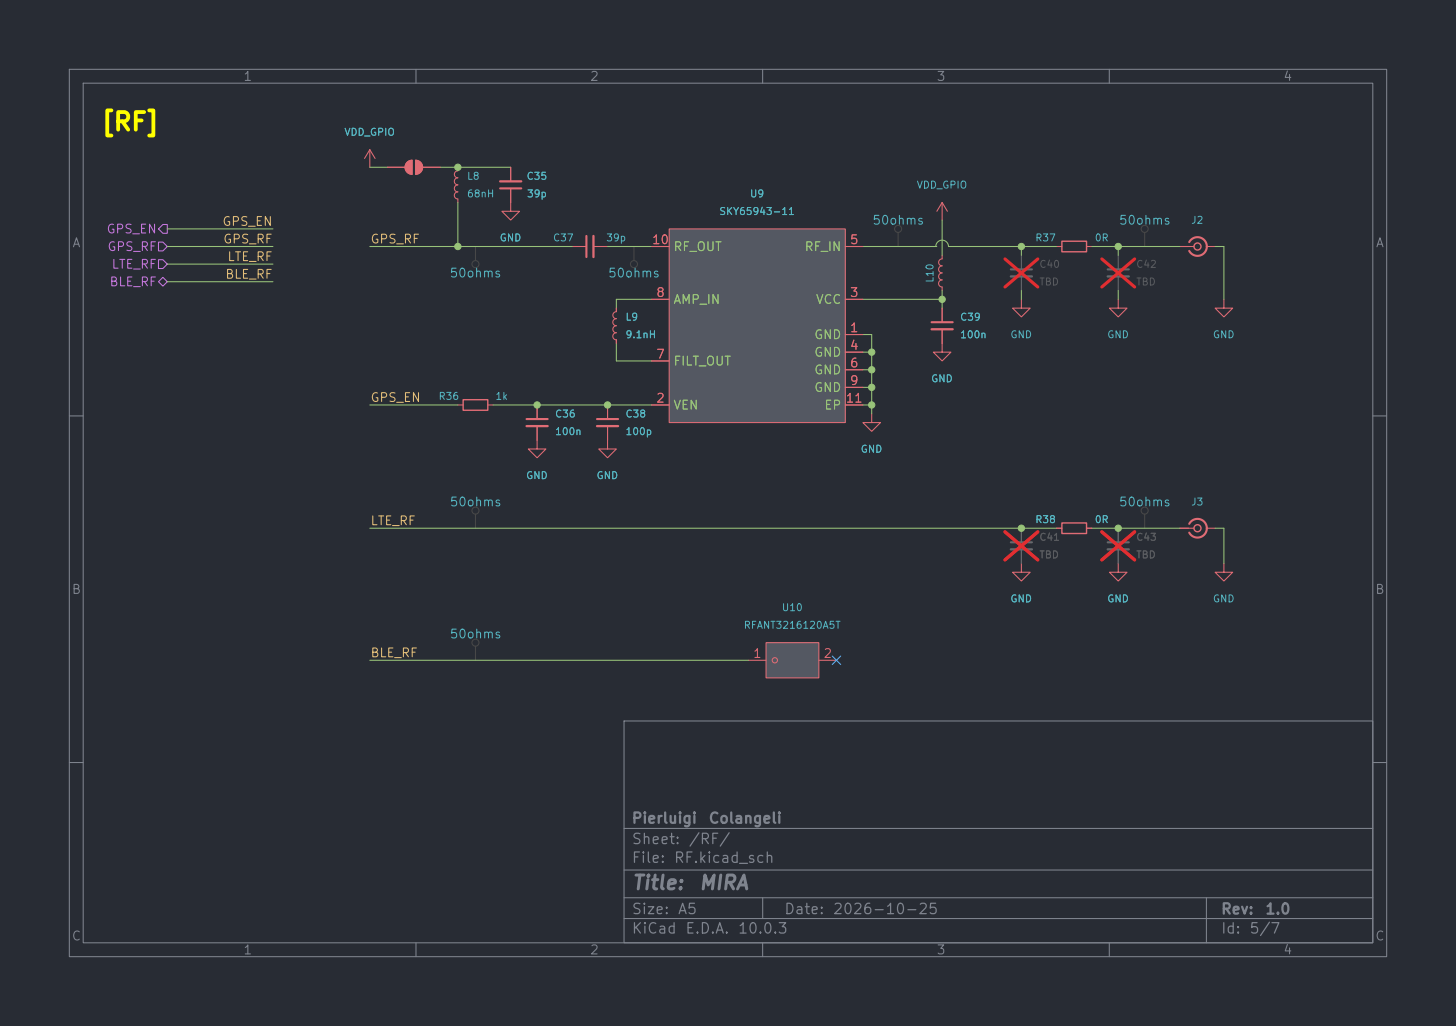
[picture p5: page 5]

Size: A5 | Rev: 1.0 | C Date: 2026-10-25
KiCad E.D.A. 10.0.3 | Id: 5/7

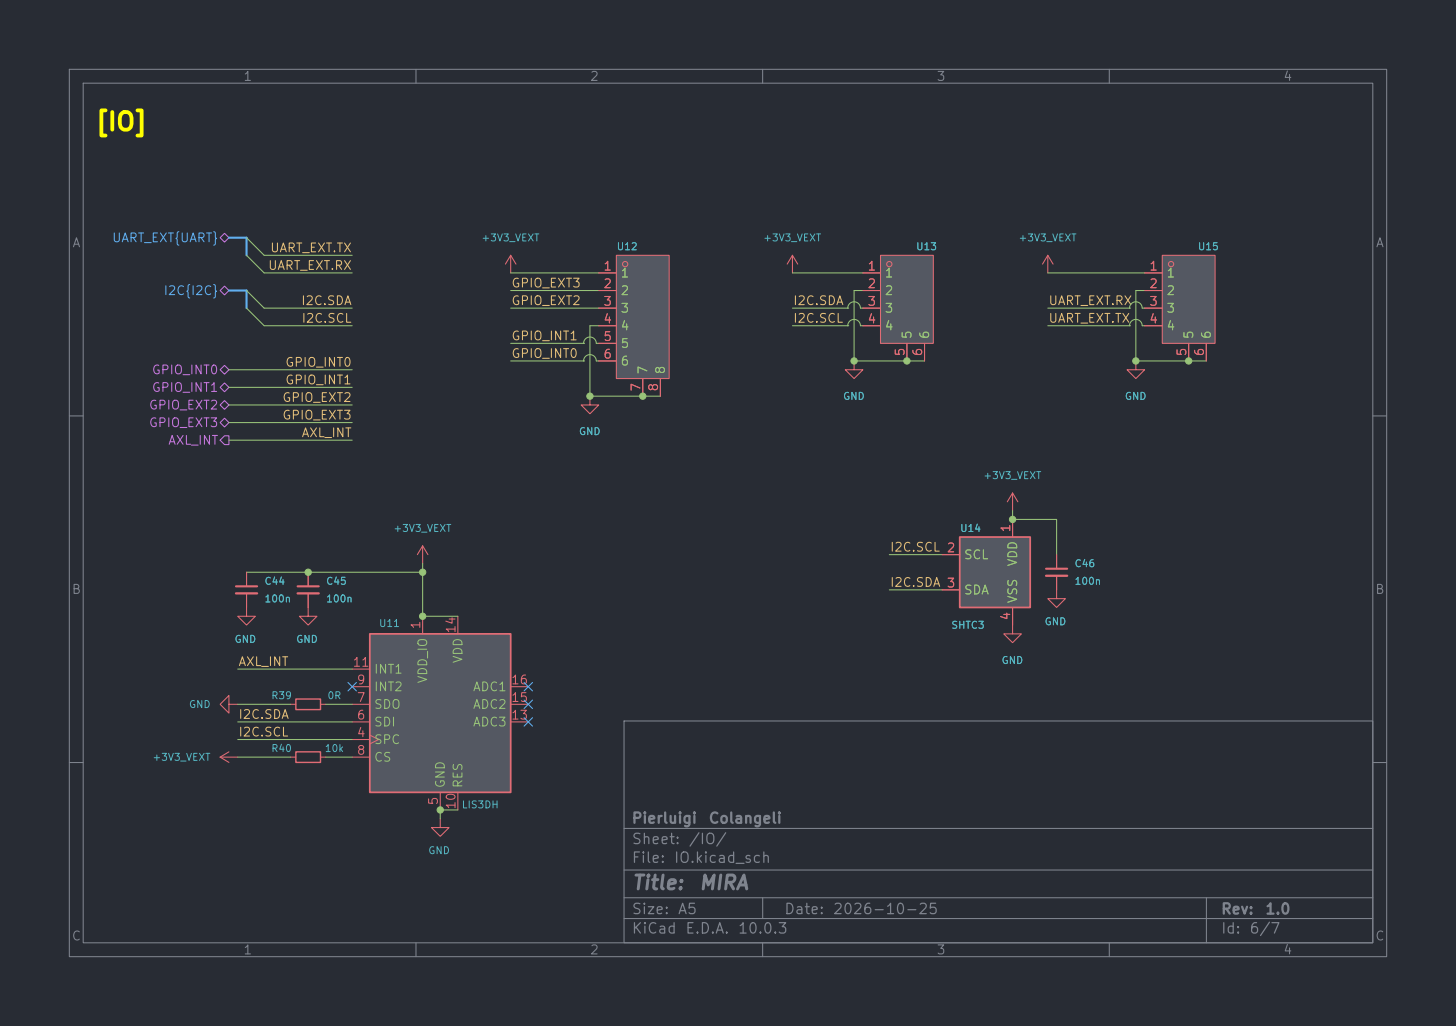
[picture p6: page 6]

Size: A5 | Rev: 1.0 | C Date: 2026-10-25
KiCad E.D.A. 10.0.3 | Id: 6/7

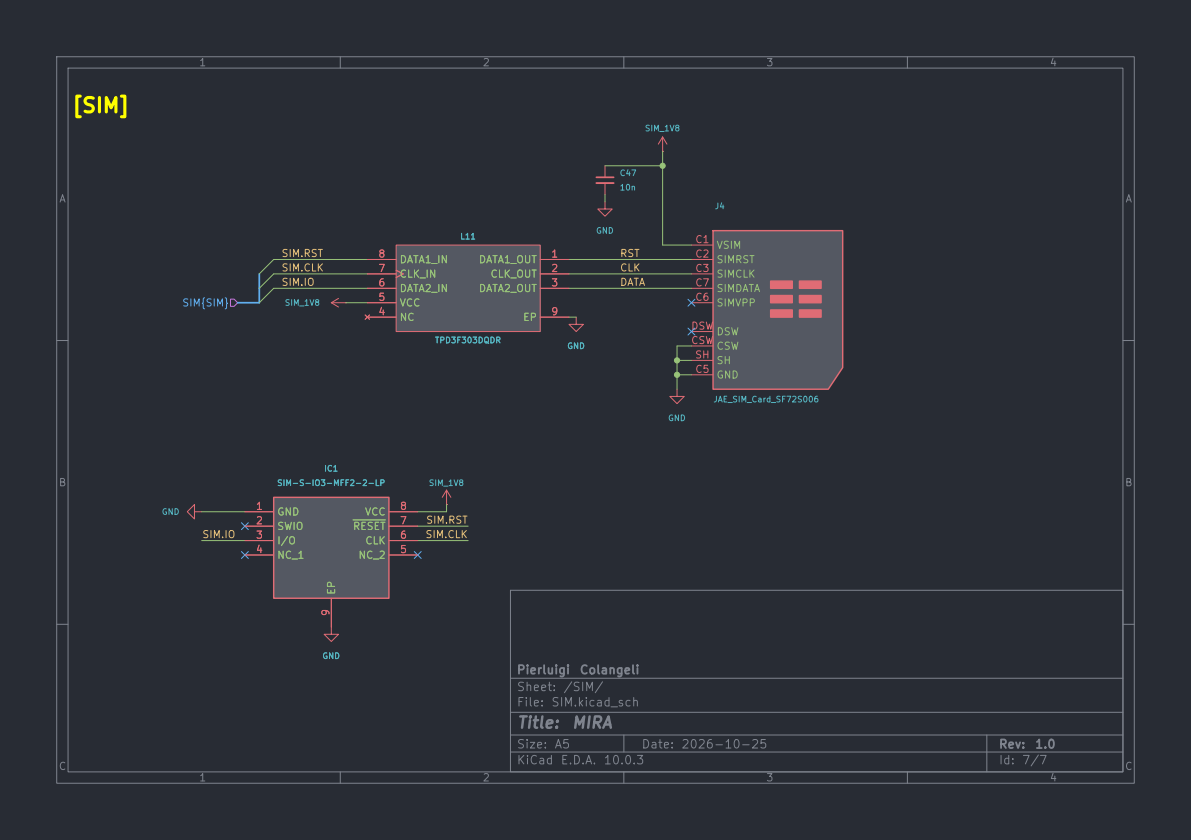
[picture p7: page 7]

SIMRST C2
SIMCLK C3 GND C5
SIMVPP C6 SIMDATA C7 CSW CSW DSW DSW

Size: A5 | Rev: 1.0 | C Date: 2026-10-25
KiCad E.D.A. 10.0.3 | Id: 7/7
