piecol/MIRA/MIRA.kicad_pcb

## KiCad design MIRA.kicad_pcb (2026-10-25)

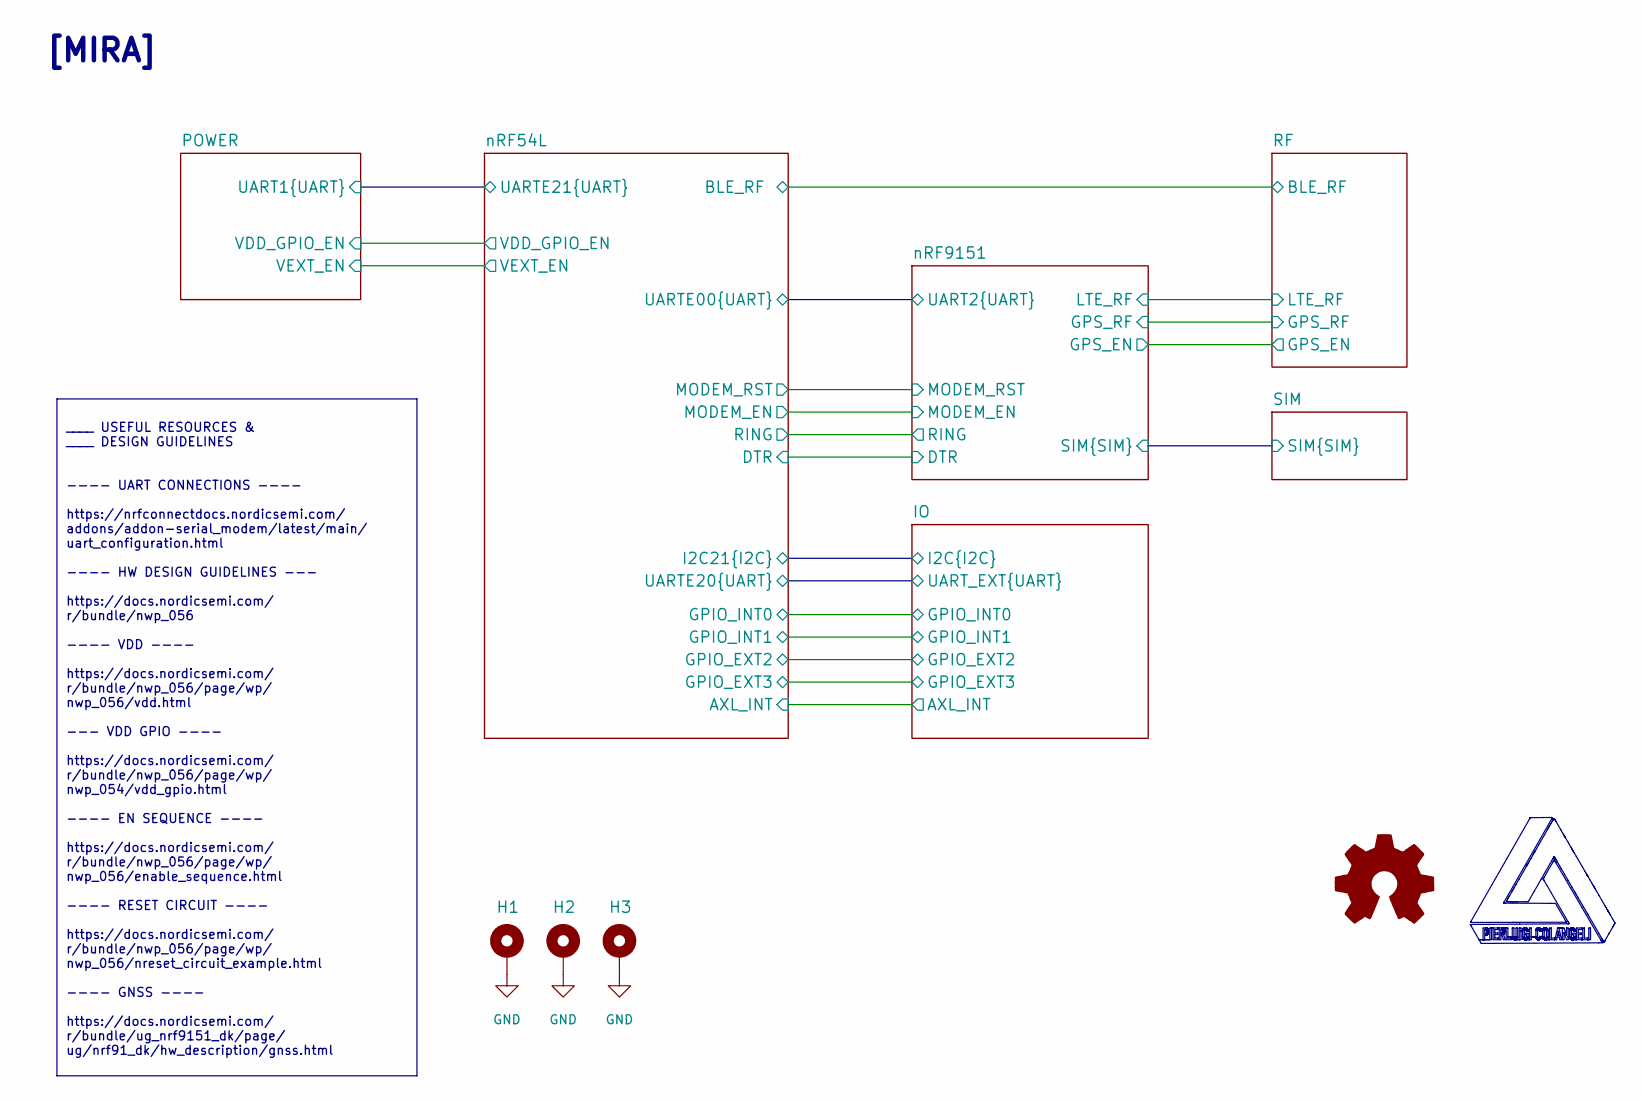
[picture p8: schematic MIRA.kicad_sch]

Parts:
H1, H2, H3: MountingHole_Pad; MountingHole_2.2mm_M2_ISO7380_Pad

Connections:
GND: H1.1 (1_1), H2.1 (1_1), H3.1 (1_1); also elsewhere on the board

Notes on the sheet:
[MIRA]
____ USEFUL RESOURCES & ____ DESIGN GUIDELINES ---- UART CONNECTIONS ---- https://nrfconnectdocs.nordicsemi.com/ addons/addon-serial_modem/latest/main/ uart_configuration.html ---- HW DESIGN GUIDELINES --- https://docs.nordicsemi.com/ r/bundle/nwp_056 ---- VDD ---- https://docs.nordicsemi.com/ r/bu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

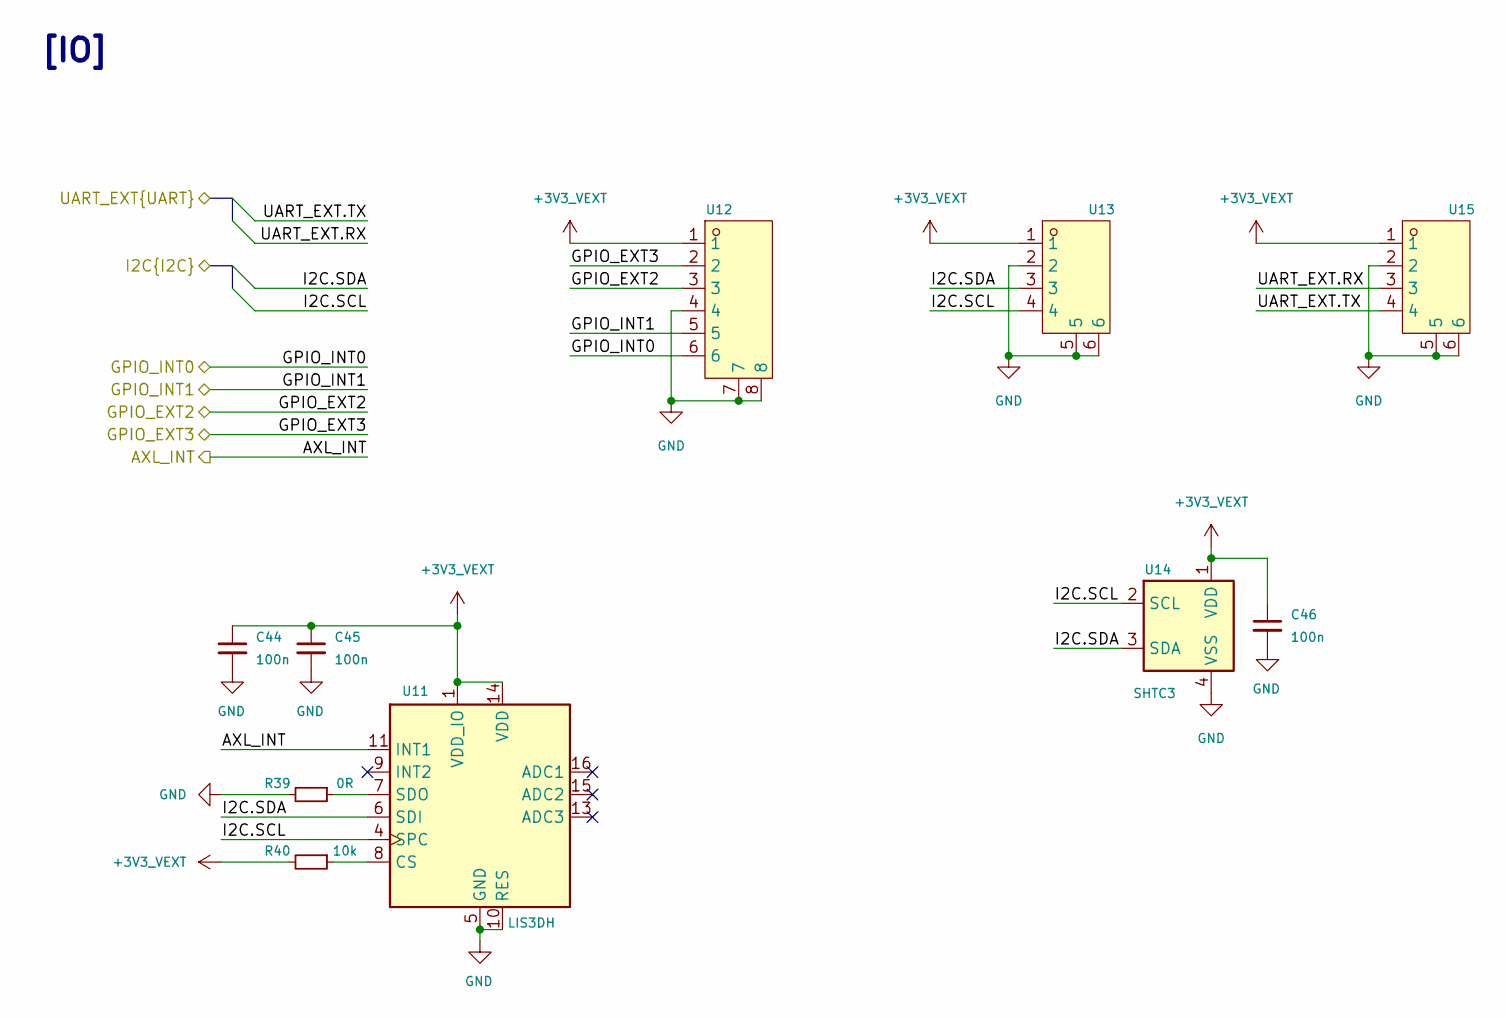
[picture p9: schematic IO.kicad_sch, MIRA]

Parts:
C44, C45, C46: 100n; C_0402_1005Metric; LCSC C1525
R39: 0R; R_0402_1005Metric; LCSC C17168
R40: 10k; R_0402_1005Metric; LCSC C25744
U11: LIS3DH; LGA-16_3x3mm_P0.5mm_LayoutBorder3x5y; LCSC Part C15134
U12: ZX-GH1.25-WT6; CONN-SMD_6P-P1.25_ZX-GH1.25-WT6; MPN ZX-GH1.25-WT6; LCSC Part C7429519
U13, U15: ZX-GH1.25-WT4; CONN-SMD_4P-P1.25_ZX-GH1.25-WT4; MPN ZX-GH1.25-WT4; LCSC Part C7429517
U14: SHTC3; Sensirion_DFN-4-1EP_2x2mm_P1mm_EP0.7x1.6mm; LCSC C194656

Connections:
+3V3_VEXT: C44.1, C45.1, C46.1, R40.2, U11.1 (VDD_IO), U11.14 (VDD), U12.1, U13.1, U14.1 (VDD), U15.1; also elsewhere on the board
/IO/AXL_INT: U11.11 (INT1); also elsewhere on the board
/IO/GPIO_EXT2: U12.3; also elsewhere on the board
/IO/GPIO_EXT3: U12.2; also elsewhere on the board
/IO/GPIO_INT0: U12.6; also elsewhere on the board
/IO/GPIO_INT1: U12.5; also elsewhere on the board
/IO/I2C.SCL: U11.4 (SPC), U13.4, U14.2 (SCL); also elsewhere on the board
/IO/I2C.SDA: U11.6 (SDI), U13.3, U14.3 (SDA); also elsewhere on the board
/IO/UART_EXT.RX: U15.3; also elsewhere on the board
/IO/UART_EXT.TX: U15.4; also elsewhere on the board
GND: C44.2, C45.2, C46.2, R39.2, U11.5 (GND), U11.10 (RES), U11.12 (GND), U12.4, U12.7, U12.8, U13.2, U13.5, U13.6, U14.4 (VSS), U15.2, U15.5, U15.6; also elsewhere on the board
unnamed: R40.1, U11.8 (CS)
unnamed: R39.1, U11.7 (SDO)

Notes on the sheet:
[IO]

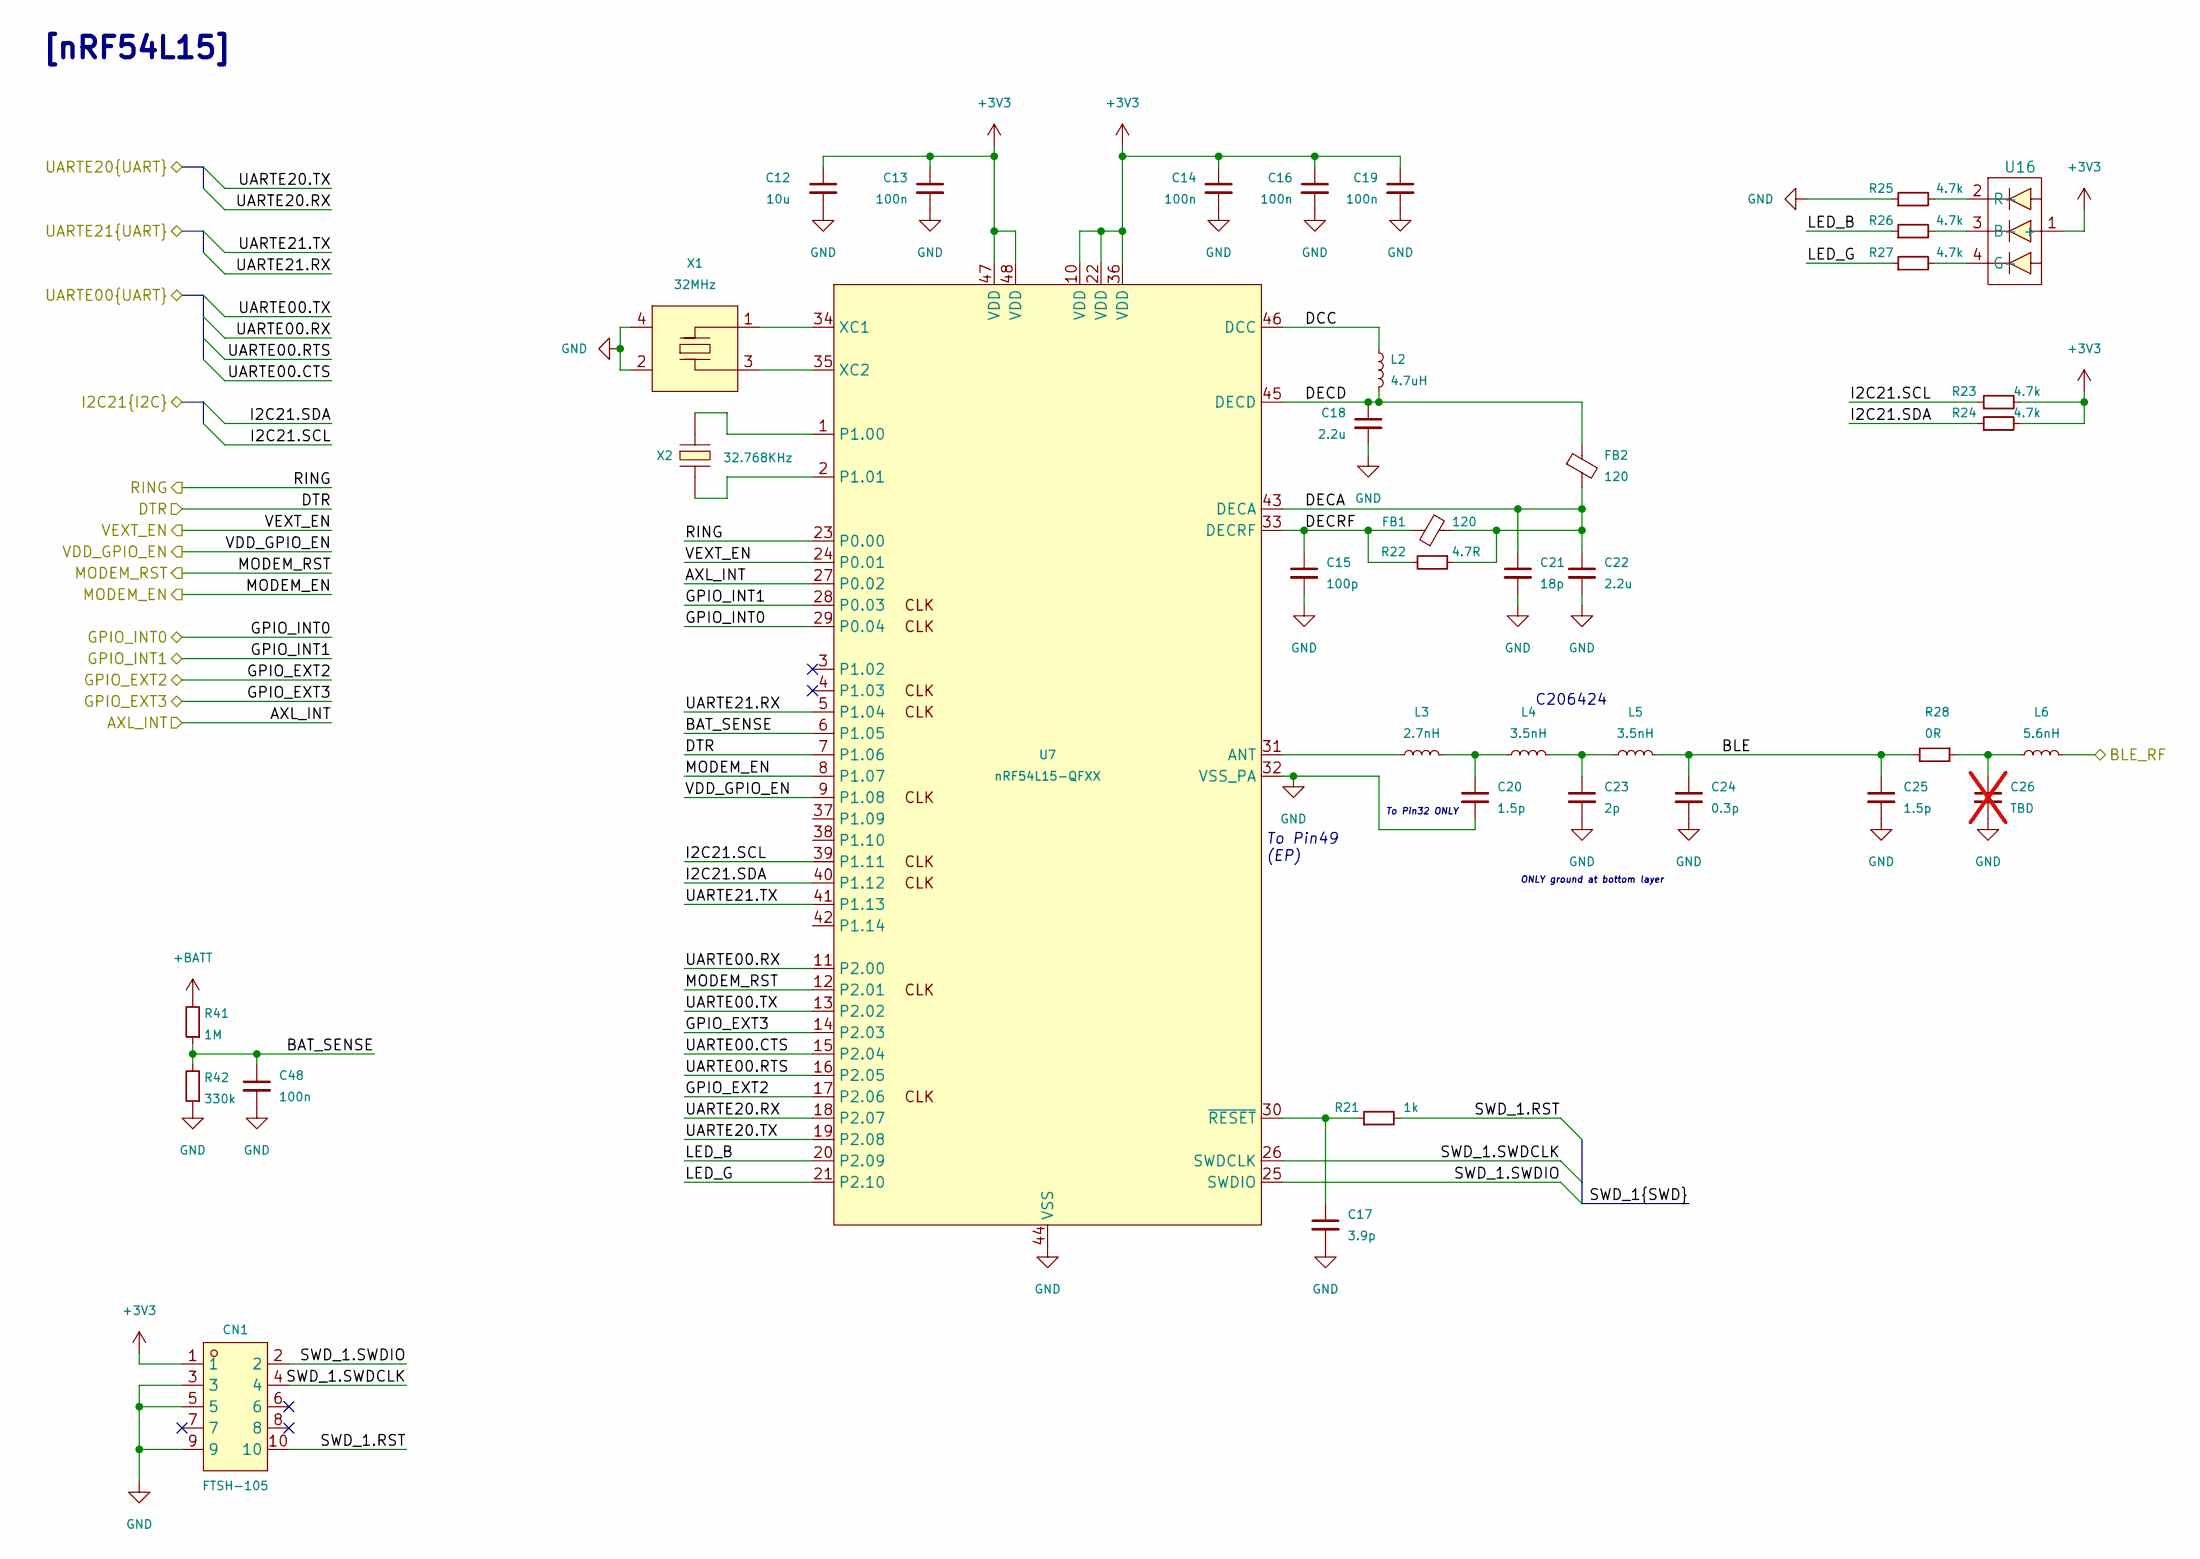
[picture p10: schematic nRF54L.kicad_sch, MIRA]

Parts:
C12: 10u; C_0402_1005Metric; LCSC C15525
C13, C14, C16, C19, C48: 100n; C_0201_0603Metric; LCSC C49062
C15: 100p; C_0201_0603Metric; LCSC C76917
C17: 3.9p; C_0201_0603Metric; LCSC C76926
C18, C22: 2.2u; C_0201_0603Metric; LCSC C318539
C20: 1.5p; C_0201_0603Metric; LCSC C88913
C21: 18p; C_0201_0603Metric; LCSC C161374
C23: 2p; C_0201_0603Metric; LCSC C668326
C24: 0.3p; C_0201_0603Metric; LCSC C76927
C25: 1.5p; C_0402_1005Metric; LCSC C76901
C26: TBD; C_0402_1005Metric; not fitted
CN1: FTSH-105; CONN-SMD_FTSH-105-01-L-DV-K-TR; LCSC Part C448647
FB1, FB2: 120; L_0201_0603Metric; LCSC C97850
L2: 4.7uH; L_0603_1608Metric; LCSC C76799
L3: 2.7nH; L_0201_0603Metric; LCSC C7216765
L4, L5: 3.5nH; L_0201_0603Metric; LCSC C206424
L6: 5.6nH; L_0402_1005Metric; LCSC C85670
R21: 1k; R_0402_1005Metric; LCSC C11702
R22: 4.7R; R_0402_1005Metric; LCSC C25121
R23, R24, R25, R26, R27: 4.7k; R_0402_1005Metric; LCSC C25900
R28: 0R; R_0402_1005Metric; LCSC C17168
R41: 1M; R_0402_1005Metric; LCSC C26083
R42: 330k; R_0402_1005Metric; LCSC C25778
U7: nRF54L15-QFXX; QFN-48-1EP_6x6mm_P0.4mm_EP4.6x4.6mm; LCSC C42458750
U16: APHF1608LSEEQBDZGKC; LED-SMD_4P-L1.6-W0.8_APHF1608LSEEQBDZGKC; MPN APHF1608LSEEQBDZGKC; LCSC Part C3019171
X1: 32MHz; CRYSTAL-SMD_4P-L1.6-W1.2-BL; LCSC Part C655046
X2: 32.768KHz; Crystal_SMD_MicroCrystal_CM9V-T1A-2Pin_1.6x1.0mm; LCSC Part C596929

Connections:
+3V3: C12.1, C13.1, C14.1, C16.1, C19.1, CN1.1, R23.2, R24.2, U7.10 (VDD), U7.22 (VDD), U7.36 (VDD), U7.47 (VDD), U7.48 (VDD), U16.1 (+); also elsewhere on the board
+BATT: R41.2; also elsewhere on the board
/IO/AXL_INT: U7.27 (P0.02); also elsewhere on the board
/IO/GPIO_EXT2: U7.17 (P2.06); also elsewhere on the board
/IO/GPIO_EXT3: U7.14 (P2.03); also elsewhere on the board
/IO/GPIO_INT0: U7.29 (P0.04); also elsewhere on the board
/IO/GPIO_INT1: U7.28 (P0.03); also elsewhere on the board
/IO/I2C.SCL: R23.1, U7.39 (P1.11); also elsewhere on the board
/IO/I2C.SDA: R24.1, U7.40 (P1.12); also elsewhere on the board
/IO/UART_EXT.RX: U7.18 (P2.07); also elsewhere on the board
/IO/UART_EXT.TX: U7.19 (P2.08); also elsewhere on the board
/POWER/UART1.RX: U7.5 (P1.04); also elsewhere on the board
/POWER/UART1.TX: U7.41 (P1.13); also elsewhere on the board
/RF/BLE_RF: L6.2; also elsewhere on the board
/nRF54L/BAT_SENSE: C48.1, R41.1, R42.2, U7.6 (P1.05)
/nRF54L/BLE: C24.1, C25.1, L5.2, R28.2
/nRF54L/DCC: L2.1, U7.46 (DCC)
/nRF54L/DECA: C21.1, C22.1, FB1.2, FB2.2, R22.1, U7.43 (DECA)
/nRF54L/DECD: C18.1, FB2.1, L2.2, U7.45 (DECD)
/nRF54L/DECRF: C15.1, FB1.1, R22.2, U7.33 (DECRF)
/nRF54L/DTR: U7.7 (P1.06); also elsewhere on the board
/nRF54L/LED_B: R26.1, U7.20 (P2.09)
/nRF54L/LED_G: R27.1, U7.21 (P2.10)
/nRF54L/MODEM_EN: U7.8 (P1.07); also elsewhere on the board
/nRF54L/MODEM_RST: U7.12 (P2.01); also elsewhere on the board
/nRF54L/RING: U7.23 (P0.00); also elsewhere on the board
/nRF54L/SWD_1.RST: CN1.10, R21.2
/nRF54L/SWD_1.SWDCLK: CN1.4, U7.26 (SWDCLK)
/nRF54L/SWD_1.SWDIO: CN1.2, U7.25 (SWDIO)
/nRF54L/UARTE00.CTS: U7.15 (P2.04); also elsewhere on the board
/nRF54L/UARTE00.RTS: U7.16 (P2.05); also elsewhere on the board
/nRF54L/UARTE00.RX: U7.11 (P2.00); also elsewhere on the board
/nRF54L/UARTE00.TX: U7.13 (P2.02); also elsewhere on the board
/nRF54L/VDD_GPIO_EN: U7.9 (P1.08); also elsewhere on the board
/nRF54L/VEXT_EN: U7.24 (P0.01); also elsewhere on the board
GND: C12.2, C13.2, C14.2, C15.2, C16.2, C17.2, C18.2, C19.2, C20.2, C21.2, C22.2, C23.2, C24.2, C25.2, C26.2, C48.2, CN1.3, CN1.5, CN1.9, R25.1, R42.1, U7.32 (VSS_PA), U7.44 (VSS), U7.49 (VSS), X1.2 (GND), X1.4 (GND); also elsewhere on the board
unnamed: C20.1, L3.2, L4.1
unnamed: C23.1, L4.2, L5.1
unnamed: C26.1, L6.1, R28.1
unnamed: L3.1, U7.31 (ANT)
unnamed: U7.1 (P1.00), X2.1
unnamed: U7.2 (P1.01), X2.2
unnamed: U7.34 (XC1), X1.1
unnamed: U7.35 (XC2), X1.3
unnamed: C17.1, R21.1, U7.30 (~RESET)
unnamed: R26.2, U16.3 (B-)
unnamed: R27.2, U16.4 (G-)
unnamed: R25.2, U16.2 (R-)

Notes on the sheet:
To Pin49 (EP)
C206424
[nRF54L15]
ONLY ground at bottom layer
To Pin32 ONLY

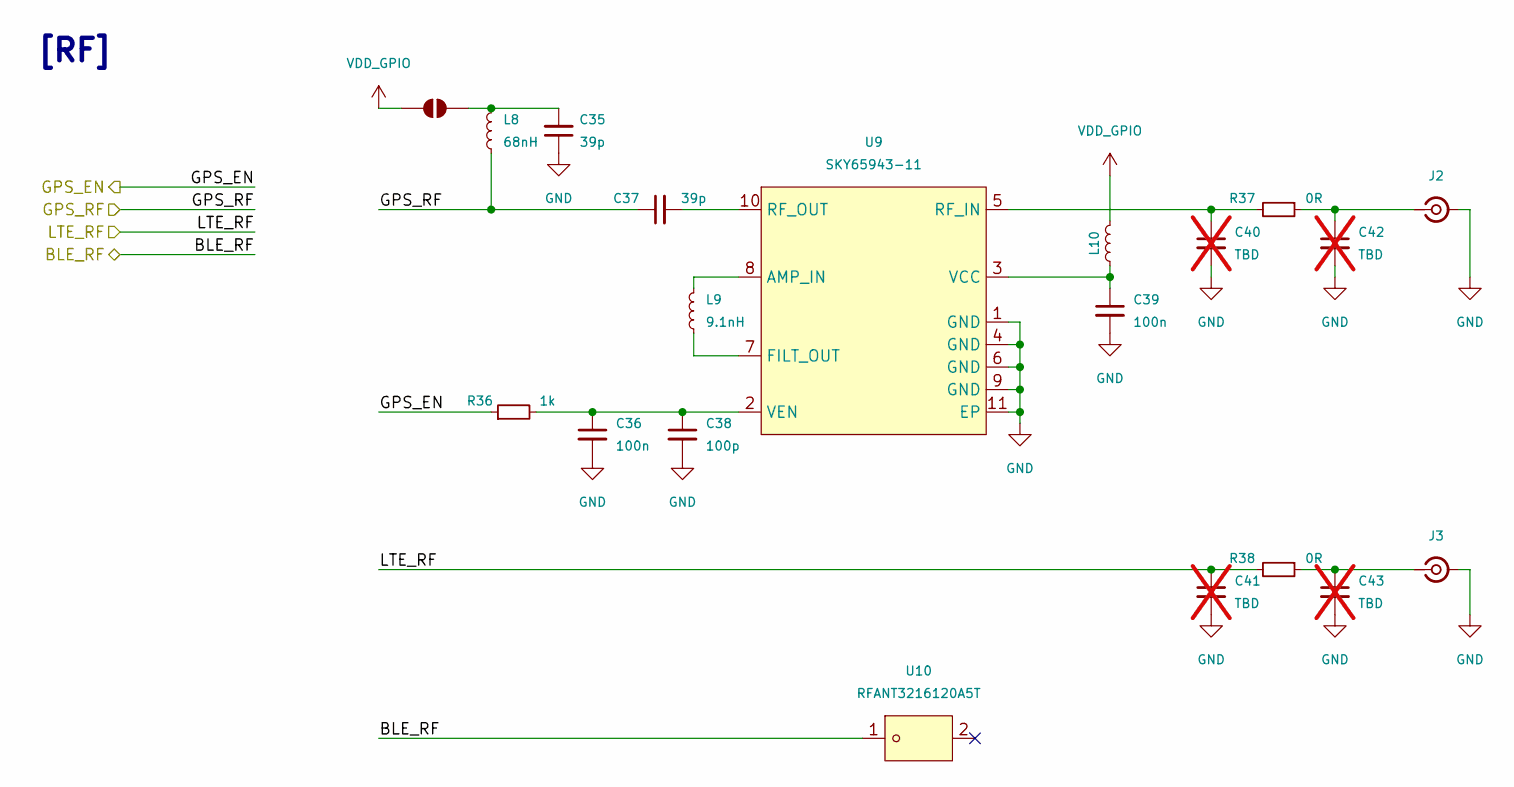
[picture p11: schematic RF.kicad_sch, MIRA]

Parts:
C35, C37: 39p; C_0402_1005Metric; LCSC C1563
C36, C39: 100n; C_0402_1005Metric; LCSC C1525
C38: 100p; C_0201_0603Metric; LCSC C76917
C40, C41, C42, C43: TBD; C_0402_1005Metric; not fitted
J2, J3: Conn_Coaxial_Small; U.FL_Molex_MCRF_73412-0110_Vertical; LCSC C22418213
JP8: SolderJumper_2_Open; SolderJumper_Mini
L8: 68nH; L_0402_1005Metric; LCSC Part C108965
L9: 9.1nH; L_0402_1005Metric; LCSC Part C113122
L10: BLM15PX121SN1D; L_0402_1005Metric; LCSC Part C88970
R36: 1k; R_0402_1005Metric; LCSC C11702
R37, R38: 0R; R_0402_1005Metric; LCSC C17168
U9: SKY65943-11; MCM-10_L2.5-W2.5-P0.50-BL-EP; MPN SKY65943-11; LCSC Part C2654442
U10: RFANT3216120A5T; FILTER-SMD_1206-2P-L3.2-W1.6-L; LCSC Part C127629

Connections:
/RF/BLE_RF: U10.1 (1_1); also elsewhere on the board
/RF/GPS_EN: R36.1; also elsewhere on the board
/RF/GPS_RF: C37.1, L8.1; also elsewhere on the board
/RF/LTE_RF: C41.1, R38.2; also elsewhere on the board
GND: C35.1, C36.2, C38.2, C39.2, C40.2, C41.2, C42.2, C43.2, J2.2 (Ext), J3.2 (Ext), U9.1 (GND), U9.4 (GND), U9.6 (GND), U9.9 (GND), U9.11 (EP); also elsewhere on the board
unnamed: C42.1, J2.1 (In), R37.1
unnamed: C43.1, J3.1 (In), R38.1
unnamed: C35.2, JP8.1 (A), L8.2
unnamed: L9.2, U9.8 (AMP_IN)
unnamed: L9.1, U9.7 (FILT_OUT)
unnamed: C40.1, R37.2, U9.5 (RF_IN)
unnamed: C37.2, U9.10 (RF_OUT)
unnamed: C39.1, L10.1, U9.3 (VCC)
unnamed: C36.1, C38.1, R36.2, U9.2 (VEN)
VDD_GPIO: JP8.2 (B), L10.2; also elsewhere on the board

Notes on the sheet:
[RF]

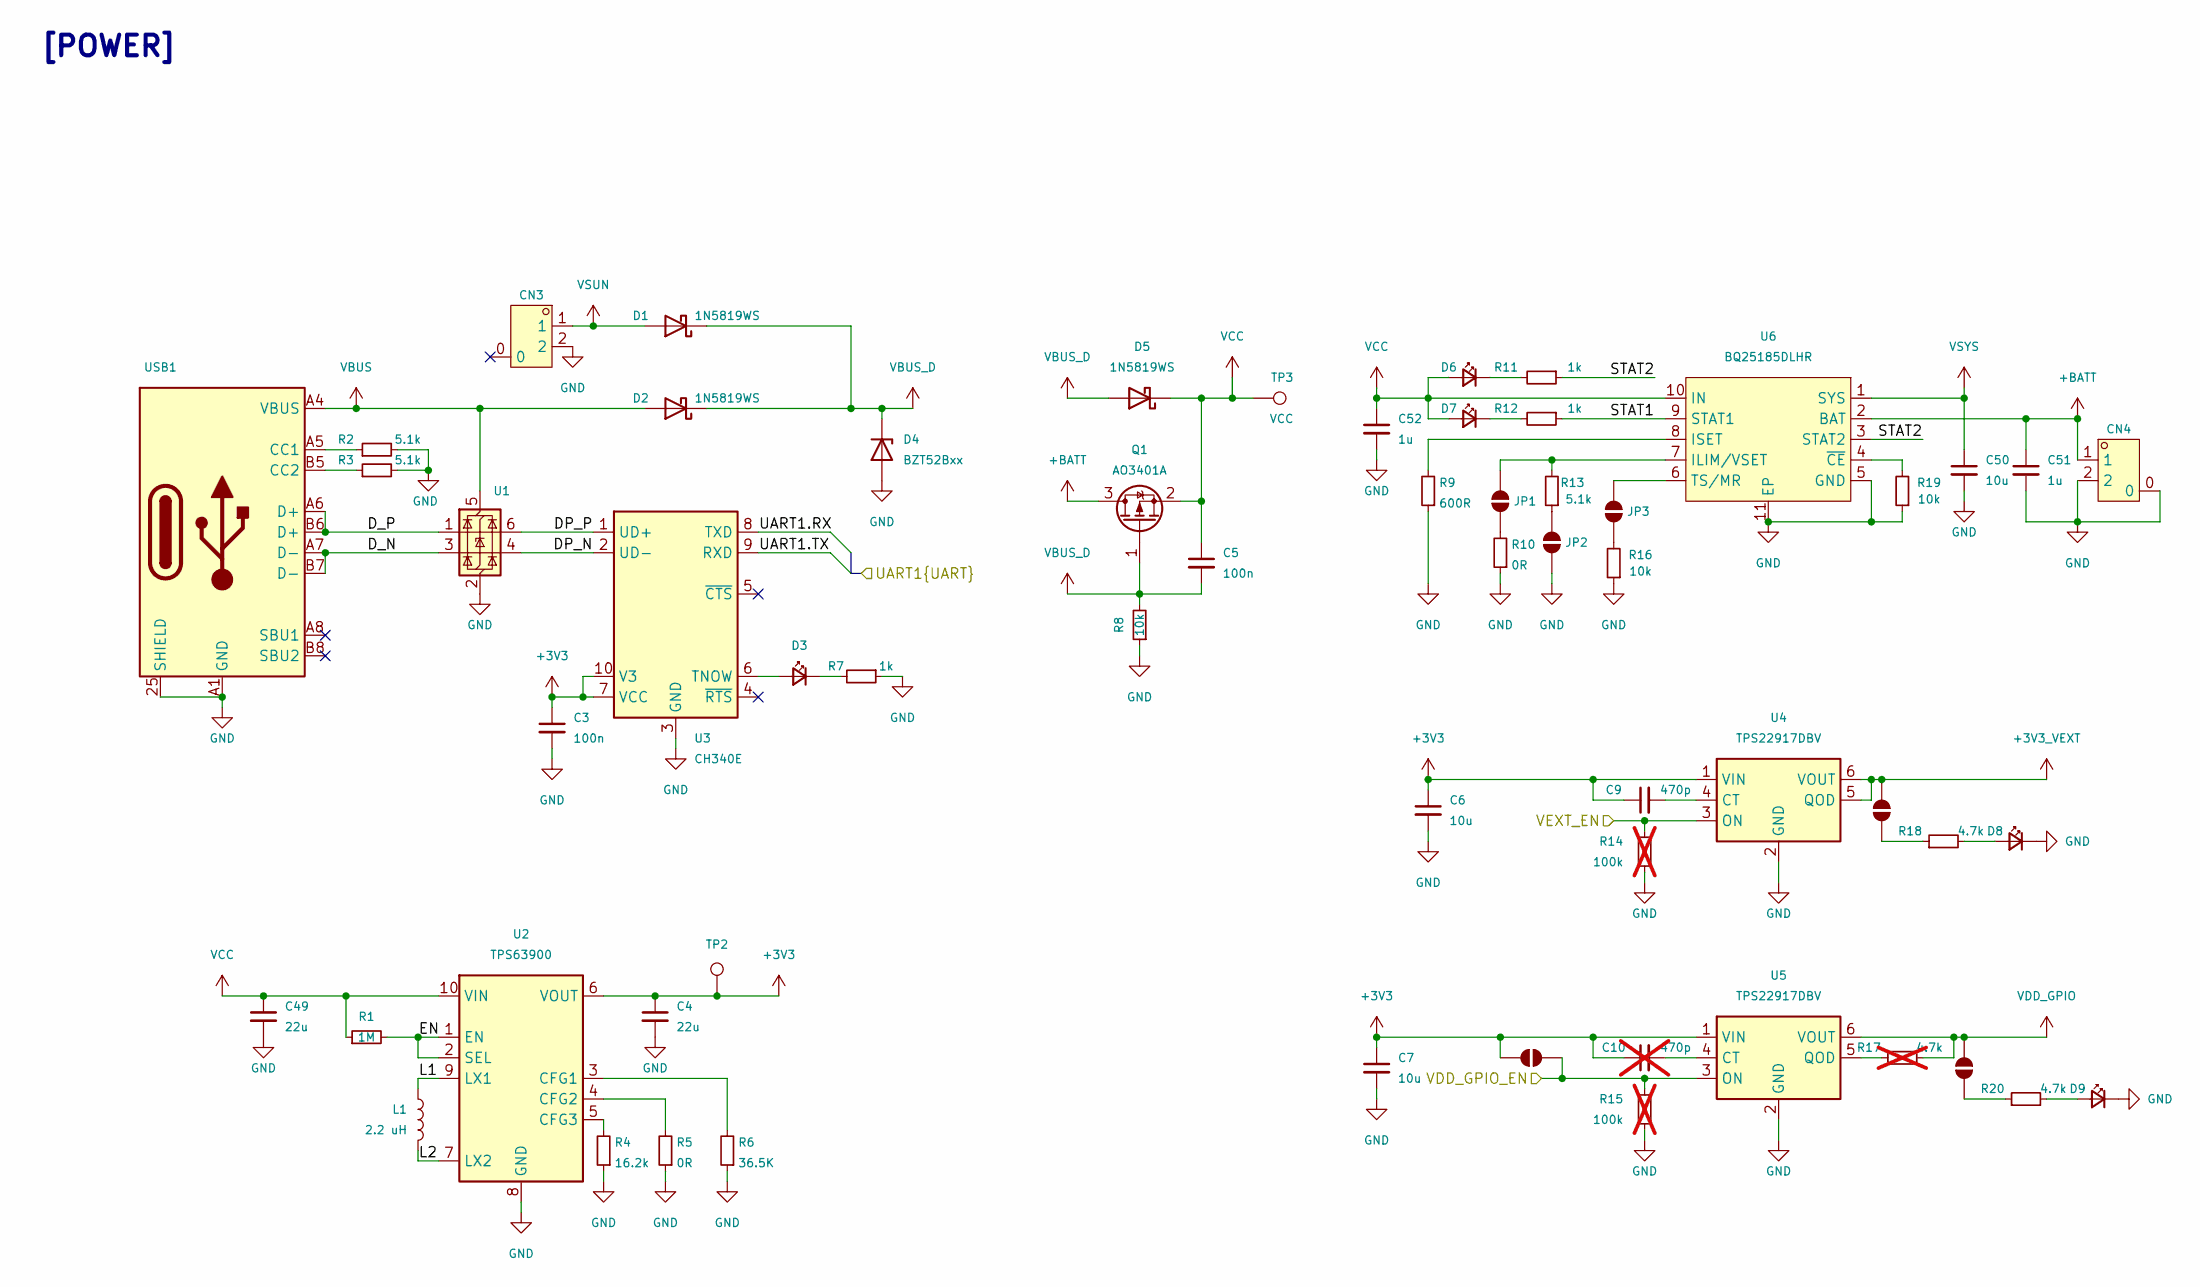
[picture p12: schematic POWER.kicad_sch, MIRA]

Parts:
C3, C5: 100n; C_0402_1005Metric; LCSC C1525
C4, C49: 22u; C_0805_2012Metric; LCSC C45783
C6, C7, C50: 10u; C_0402_1005Metric; LCSC C15525
C9: 470p; C_0402_1005Metric; LCSC C76971
C10: 470p; C_0402_1005Metric; LCSC C76971; not fitted
C51, C52: 1u; C_0402_1005Metric; LCSC C52923
CN3, CN4: 1.25mm-2P socket; CONN-SMD_1.25T-2P; MPN 1.25T-2P立贴; LCSC Part C43462
D1, D2, D5: 1N5819WS; D_SOD-323; LCSC C191023
D3, D6, D7, D8, D9: XL-1005UBC_C22355736; LED_0402_1005Metric; MPN XL-1005UBC; LCSC Part C22355736
D4: BZT52Bxx; D_SOD-123F; LCSC C52148463
JP1, JP2, JP3, JP4, JP5, JP9: SolderJumper_2_Open; SolderJumper_Mini
L1: 2.2 uH; L_Coilcraft_XxL4020; LCSC C3151182
Q1: AO3401A; SOT-23; LCSC C15127
R1: 1M; R_0402_1005Metric; LCSC C26083
R2, R3, R13: 5.1k; R_0402_1005Metric; MPN 0402WGF5101TCE; LCSC Part C25905
R4: 16.2k; R_0402_1005Metric; LCSC C27176
R5, R10: 0R; R_0402_1005Metric; LCSC C17168
R6: 36.5K; R_0402_1005Metric; LCSC C25887
R7, R11, R12: 1k; R_0402_1005Metric; LCSC C11702
R8, R16, R19: 10k; R_0402_1005Metric; LCSC C25744
R9: 600R; R_0402_1005Metric; LCSC C4961
R14, R15: 100k; R_0402_1005Metric; LCSC C25741; not fitted
R17: 4.7k; R_0402_1005Metric; LCSC C25900; not fitted
R18, R20: 4.7k; R_0402_1005Metric; LCSC C25900
TP2: TestPoint; TestPoint_Pad_D1.0mm
TP3: VCC; TestPoint_Pad_D1.5mm
U1: USBLC6-2P6; SOT-666-6_L1.6-W1.2-P0.50-LS1.6-BL; MPN TPUSBLC6-2P6; LCSC Part C2682291
U2: TPS63900; WSON-10-1EP_2.5x2.5mm_P0.5mm_EP1.2x2mm_ThermalVias; LCSC C1518762
U3: CH340E; MSOP-10_3x3mm_P0.5mm; LCSC C99652
U4, U5: TPS22917DBV; SOT-23-6; LCSC C2681320
U6: BQ25185DLHR; WSON-10_L2.2-W2.0-P0.40-BL-EP_TI_DLH0010A; MPN BQ25185DLHR; LCSC Part C19725033
USB1: HC-TYPE-C-16P-01M; USB-C-SMD_HCTL_HC-TYPE-C-16P-01M; MPN HC-TYPE-C-16P-01M; LCSC Part C2894899

Connections:
+3V3: C3.1, C4.1, C6.1, C7.1, C9.1, C10.1, JP9.2 (B), TP2.1 (1_1), U2.6 (VOUT), U3.7 (VCC), U3.10 (V3), U4.1 (VIN), U5.1 (VIN); also elsewhere on the board
+3V3_VEXT: JP4.2 (B), U4.5 (QOD), U4.6 (VOUT); also elsewhere on the board
+BATT: C51.1, CN4.1, Q1.3 (D), U6.2 (BAT); also elsewhere on the board
/POWER/DP_N: U1.4 (I/O2), U3.2 (UD-)
/POWER/DP_P: U1.6 (I/O1), U3.1 (UD+)
/POWER/D_N: U1.3 (I/O2), USB1.A7 (D-), USB1.B7 (D-)
/POWER/D_P: U1.1 (I/O1), USB1.A6 (D+), USB1.B6 (D+)
/POWER/EN: R1.2, U2.1 (EN), U2.2 (SEL)
/POWER/L1: L1.1, U2.9 (LX1)
/POWER/L2: L1.2, U2.7 (LX2)
/POWER/STAT1: R12.1, U6.9 (STAT1)
/POWER/STAT2: R11.1, U6.3 (STAT2)
/POWER/UART1.RX: U3.8 (TXD); also elsewhere on the board
/POWER/UART1.TX: U3.9 (RXD); also elsewhere on the board
/nRF54L/VDD_GPIO_EN: JP9.1 (A), R15.2, U5.3 (ON); also elsewhere on the board
/nRF54L/VEXT_EN: R14.2, U4.3 (ON); also elsewhere on the board
GND: C3.2, C4.2, C6.2, C7.2, C49.2, C50.2, C51.2, C52.2, CN3.2, CN4.0, CN4.2, D4.2 (A), D8.1 (K), D9.1 (K), JP2.1 (A), R2.2, R3.2, R4.1, R5.1, R6.1, R7.1, R8.1, R9.1, R10.1, R14.1, R15.1, R16.1, R19.1, U1.2 (GND), U2.8 (GND), U2.11 (GND), U3.3 (GND), U4.2 (GND), U5.2 (GND), U6.5 (GND), U6.11 (EP), USB1.25 (SHIELD), USB1.26 (SHIELD), USB1.27 (SHIELD), USB1.28 (SHIELD), USB1.A1 (GND), USB1.A12 (GND), USB1.B1 (GND), USB1.B12 (GND); also elsewhere on the board
unnamed: D3.2 (A), U3.6 (TNOW)
unnamed: D3.1 (K), R7.2
unnamed: D6.1 (K), R11.2
unnamed: D7.1 (K), R12.2
unnamed: D8.2 (A), R18.2
unnamed: D9.2 (A), R20.2
unnamed: JP1.1 (A), R10.2
unnamed: JP1.2 (B), R13.2, U6.7 (ILIM/VSET)
unnamed: JP2.2 (B), R13.1
unnamed: JP3.1 (A), R16.2
unnamed: JP3.2 (B), U6.6 (TS/MR)
unnamed: JP4.1 (A), R18.1
unnamed: JP5.1 (A), R20.1
unnamed: R6.2, U2.3 (CFG1)
unnamed: R5.2, U2.4 (CFG2)
unnamed: R4.2, U2.5 (CFG3)
unnamed: C9.2, U4.4 (CT)
unnamed: C10.2, U5.4 (CT)
unnamed: R17.1, U5.5 (QOD)
unnamed: R9.2, U6.8 (ISET)
unnamed: R19.2, U6.4 (~CE)
unnamed: R2.1, USB1.A5 (CC1)
unnamed: R3.1, USB1.B5 (CC2)
VBUS: D2.2 (A), U1.5 (VBUS), USB1.A4 (VBUS), USB1.A9 (VBUS), USB1.B4 (VBUS), USB1.B9 (VBUS)
VBUS_D: C5.2, D1.1 (K), D2.1 (K), D4.1 (K), D5.2 (A), Q1.1 (G), R8.2
VCC: C5.1, C49.1, C52.1, D5.1 (K), D6.2 (A), D7.2 (A), Q1.2 (S), R1.1, TP3.1 (1_1), U2.10 (VIN), U6.10 (IN)
VDD_GPIO: JP5.2 (B), R17.2, U5.6 (VOUT); also elsewhere on the board
VSUN: CN3.1, D1.2 (A)
VSYS: C50.1, U6.1 (SYS); also elsewhere on the board

Notes on the sheet:
[POWER]

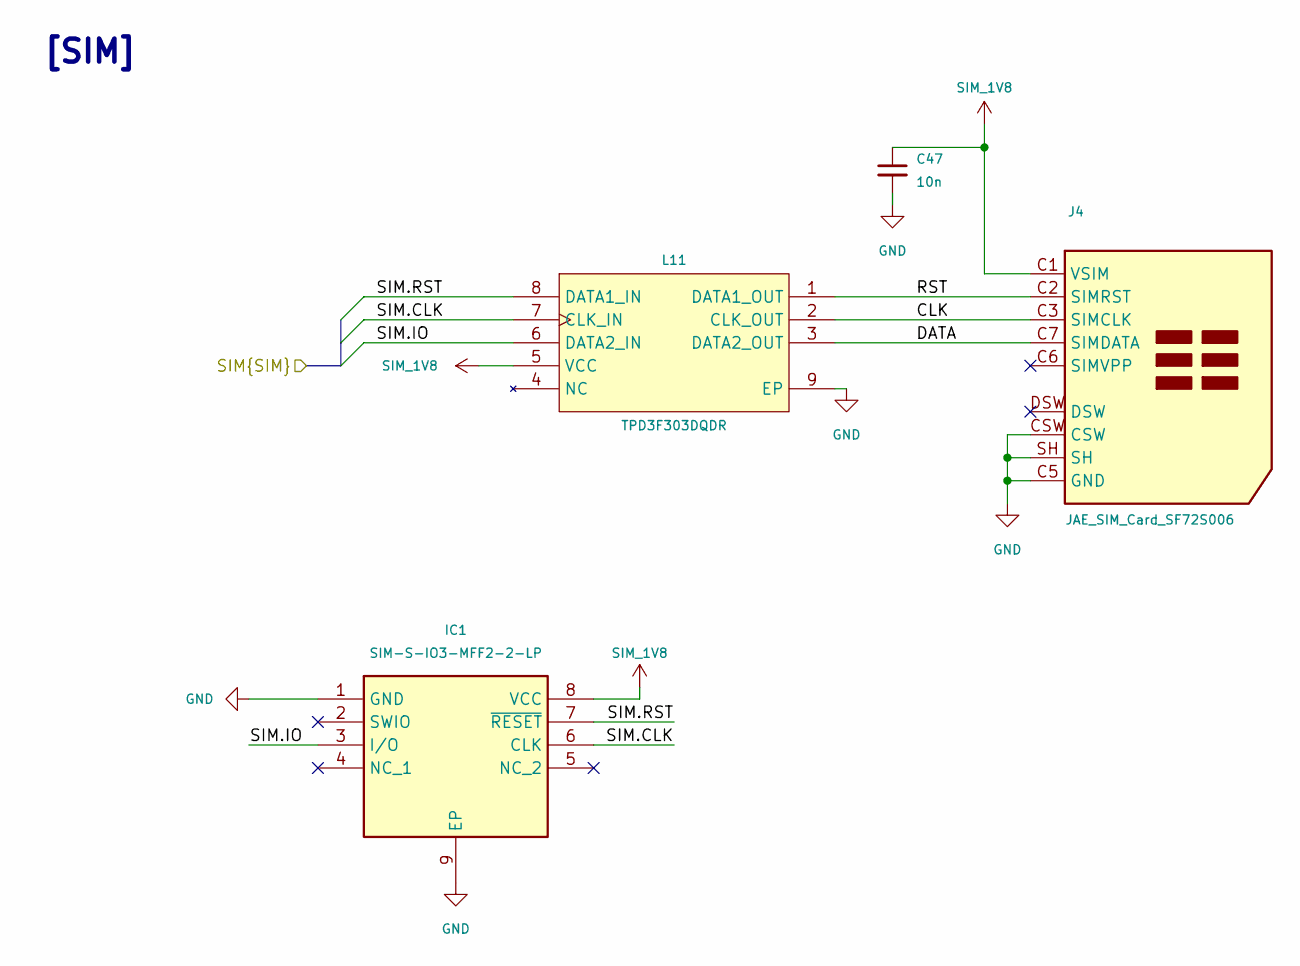
[picture p13: schematic SIM.kicad_sch, MIRA]

Parts:
C47: 10n; C_0402_1005Metric; LCSC C15195
IC1: SIM-S-IO3-MFF2-2-LP; SON127P600X500X100-9N-D; Manufacturer_Part_Number SIM-S-IO3-MFF2-2-LP; Mouser Part Number 57-SIM-S-IO3-MFF22LP
J4: JAE_SIM_Card_SF72S006; LCSC C2977286
L11: TPD3F303DQDR; WSON-8_L1.7-W1.4-P0.40-BL-EP; LCSC Part C2869050

Connections:
/SIM/CLK: J4.C3 (SIMCLK), L11.2 (CLK_OUT)
/SIM/DATA: J4.C7 (SIMDATA), L11.3 (DATA2_OUT)
/SIM/RST: J4.C2 (SIMRST), L11.1 (DATA1_OUT)
/SIM/SIM.CLK: IC1.6 (CLK), L11.7 (CLK_IN); also elsewhere on the board
/SIM/SIM.IO: IC1.3 (I/O), L11.6 (DATA2_IN); also elsewhere on the board
/SIM/SIM.RST: IC1.7 (~RESET), L11.8 (DATA1_IN); also elsewhere on the board
GND: C47.2, IC1.1 (GND), IC1.9 (EP), J4.C5 (GND), J4.CSW, J4.SH, L11.9 (EP); also elsewhere on the board
SIM_1V8: C47.1, IC1.8 (VCC), J4.C1 (VSIM), L11.5 (VCC); also elsewhere on the board

Notes on the sheet:
[SIM]
