piecol/MIRA/MIRA.kicad_pcb

## KiCad design MIRA.kicad_pcb (continued)

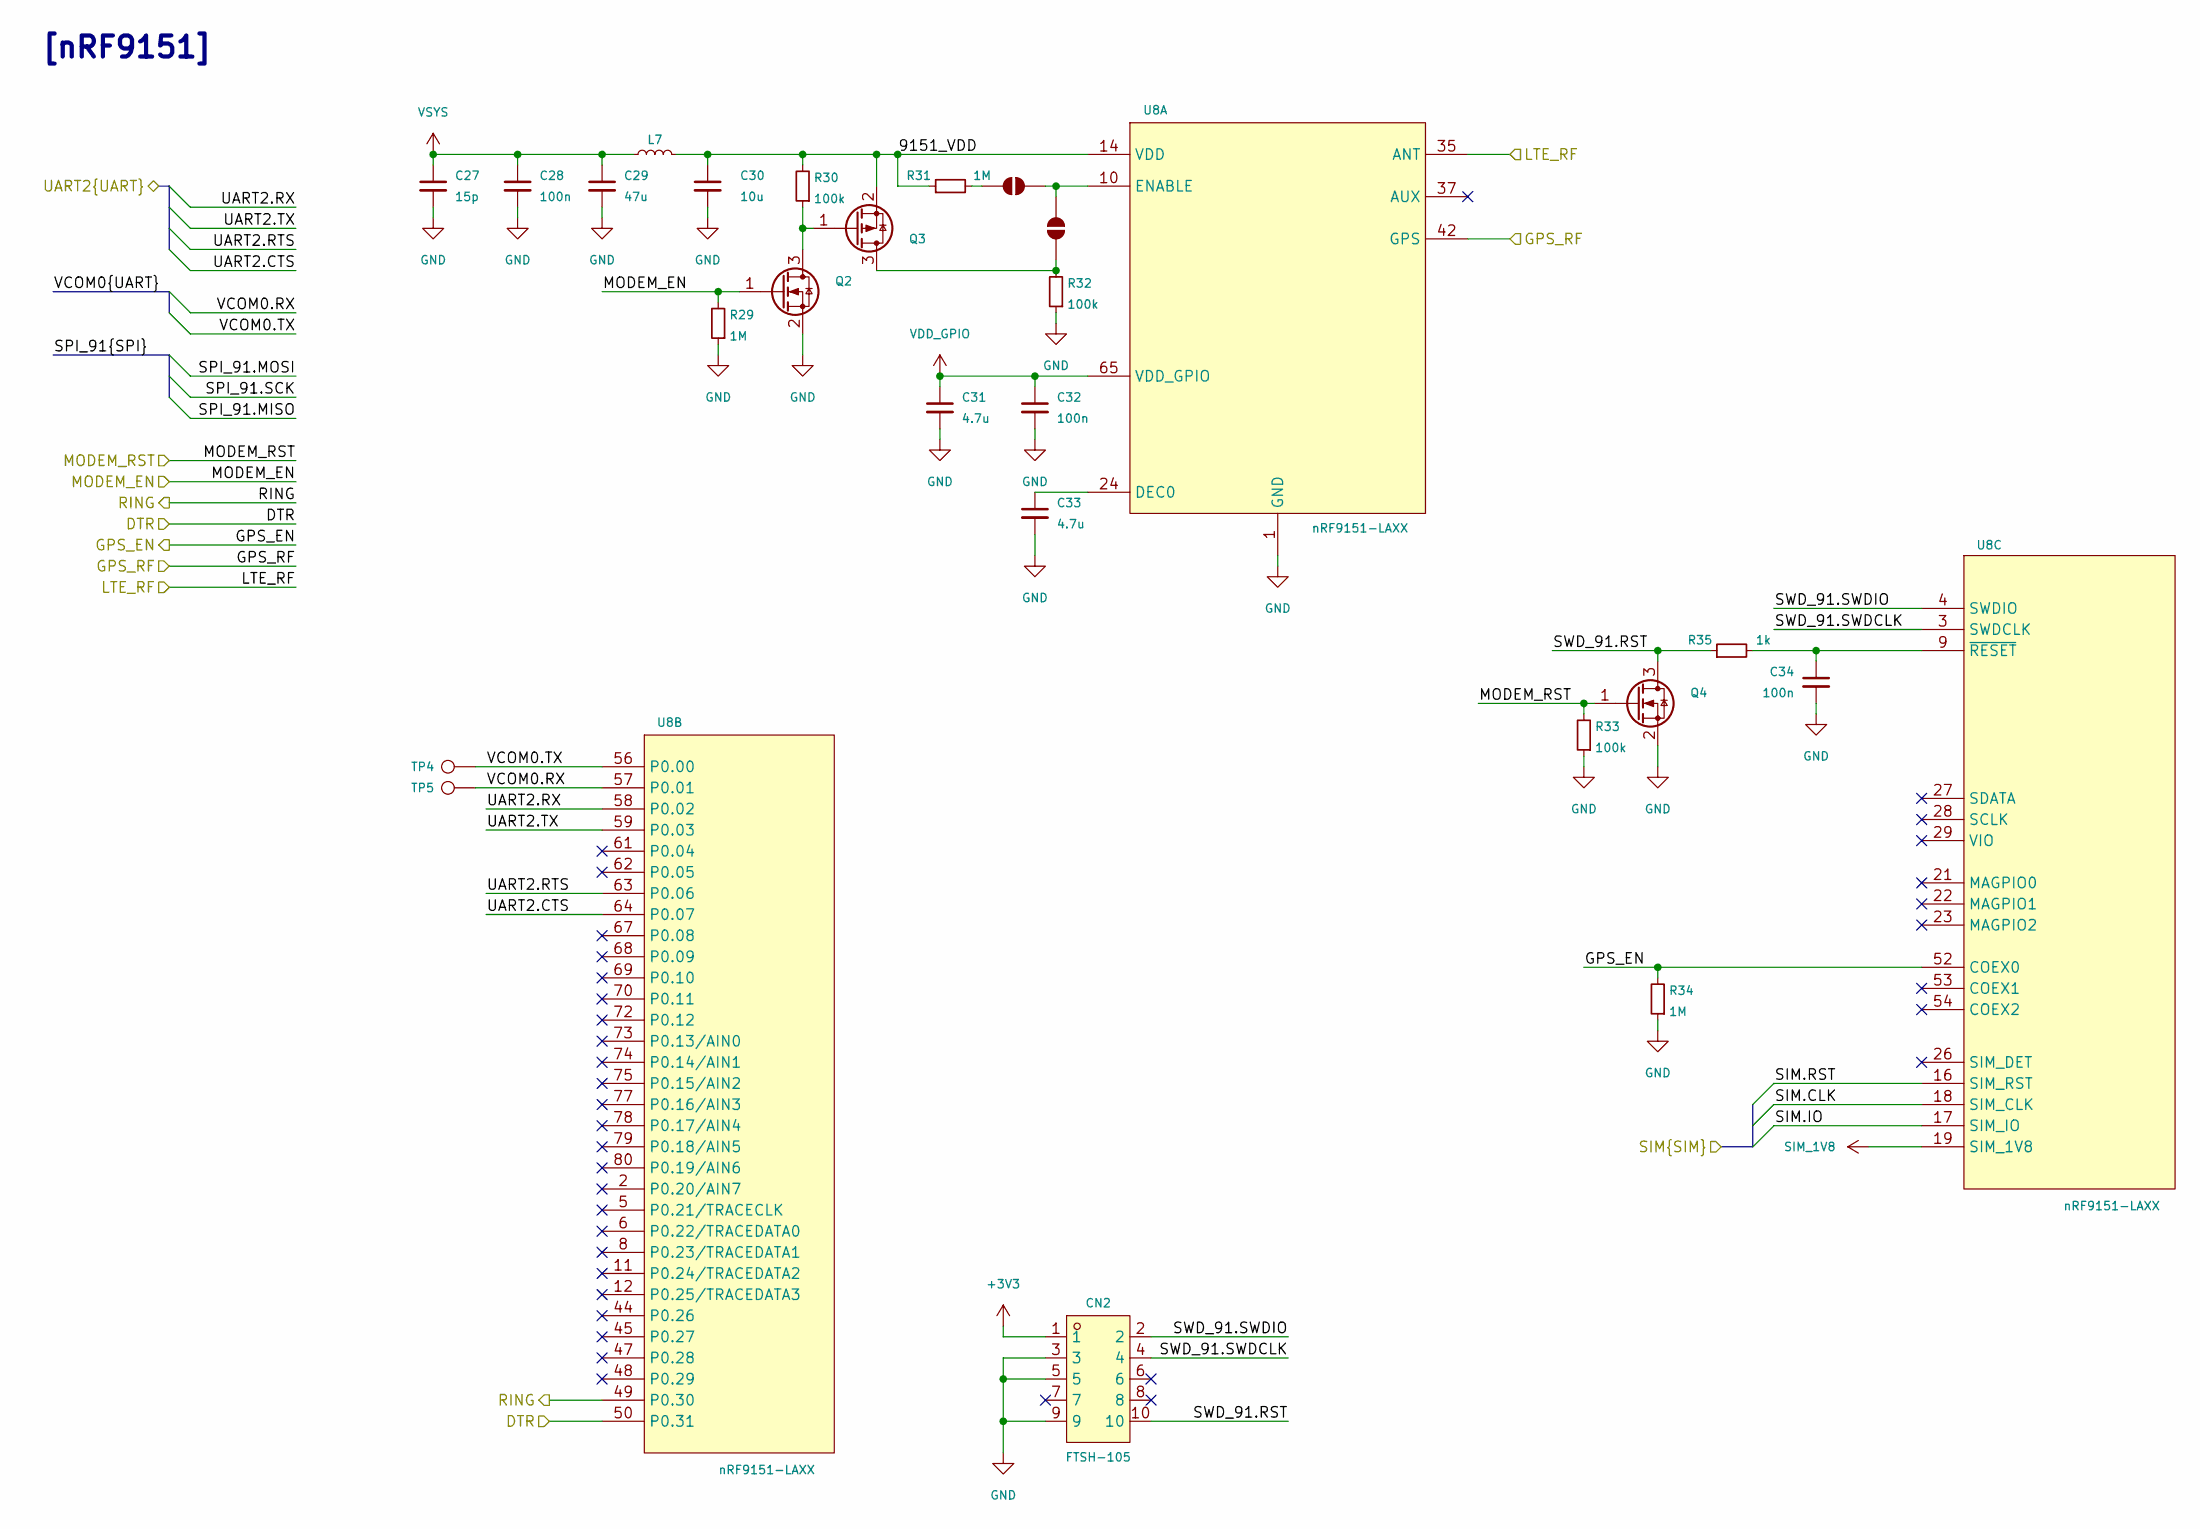
[picture p14: schematic nRF9151.kicad_sch, MIRA]

Parts:
C27: 15p; C_0402_1005Metric; LCSC C1548
C28, C32, C34: 100n; C_0402_1005Metric; LCSC C1525
C29: 47u; C_0805_2012Metric; LCSC C16780
C30: 10u; C_0402_1005Metric; LCSC C15525
C31, C33: 4.7u; C_0603_1608Metric; LCSC C19666
CN2: FTSH-105; CONN-SMD_FTSH-105-01-L-DV-K-TR; LCSC Part C448647
JP6, JP7: SolderJumper_2_Open; SolderJumper_Mini
L7: BLM15PX121SN1D; L_0402_1005Metric; LCSC Part C88970
Q2, Q4: DMN2990UFA-7B; XFDFN-3_L0.8-W0.6-P0.35-BR; MPN DMN2990UFA-7B; LCSC Part C151598
Q3: DMP22D4UFA-7B; X2-DFN0806-3_L0.8-W0.6-P0.35-BR; MPN DMP22D4UFA-7B; LCSC Part C2983692
R29, R31, R34: 1M; R_0402_1005Metric; LCSC C26083
R30, R32, R33: 100k; R_0402_1005Metric; LCSC C25741
R35: 1k; R_0402_1005Metric; LCSC C11702
TP4, TP5: TestPoint; TestPoint_Pad_D1.0mm
U8: nRF9151-LAXX; LGA_9151_12.1x11.1mm; LCSC C22397843

Connections:
+3V3: CN2.1; also elsewhere on the board
/RF/GPS_EN: R34.2, U8.52 (COEX0); also elsewhere on the board
/RF/GPS_RF: U8.42 (GPS); also elsewhere on the board
/RF/LTE_RF: U8.35 (ANT); also elsewhere on the board
/SIM/SIM.CLK: U8.18 (SIM_CLK); also elsewhere on the board
/SIM/SIM.IO: U8.17 (SIM_IO); also elsewhere on the board
/SIM/SIM.RST: U8.16 (SIM_RST); also elsewhere on the board
/nRF54L/DTR: U8.50 (P0.31); also elsewhere on the board
/nRF54L/MODEM_EN: Q2.1 (G), R29.2; also elsewhere on the board
/nRF54L/MODEM_RST: Q4.1 (G), R33.2; also elsewhere on the board
/nRF54L/RING: U8.49 (P0.30); also elsewhere on the board
/nRF54L/UARTE00.CTS: U8.64 (P0.07); also elsewhere on the board
/nRF54L/UARTE00.RTS: U8.63 (P0.06); also elsewhere on the board
/nRF54L/UARTE00.RX: U8.58 (P0.02); also elsewhere on the board
/nRF54L/UARTE00.TX: U8.59 (P0.03); also elsewhere on the board
/nRF9151/9151_VDD: C30.1, L7.2, Q3.2 (S), R30.2, R31.1, U8.14 (VDD)
/nRF9151/SWD_91.RST: CN2.10, Q4.3 (D), R35.1
/nRF9151/SWD_91.SWDCLK: CN2.4, U8.3 (SWDCLK)
/nRF9151/SWD_91.SWDIO: CN2.2, U8.4 (SWDIO)
/nRF9151/VCOM0.RX: TP5.1 (1_1), U8.57 (P0.01)
/nRF9151/VCOM0.TX: TP4.1 (1_1), U8.56 (P0.00)
GND: C27.2, C28.2, C29.2, C30.2, C31.2, C32.2, C33.2, C34.2, CN2.3, CN2.5, CN2.9, Q2.2 (S), Q4.2 (S), R29.1, R32.1, R33.1, R34.1, U8.1 (GND), U8.7 (GND), U8.13 (GND), U8.15 (GND), U8.20 (GND), U8.25 (GND), U8.30 (GND), U8.34 (GND), U8.36 (GND), U8.38 (GND), U8.39 (GND), U8.40 (GND), U8.41 (GND), U8.43 (GND), U8.46 (GND), U8.51 (GND), U8.55 (GND), U8.60 (GND), U8.66 (GND), U8.71 (GND), U8.76 (GND), U8.105 (GND), U8.106 (GND), U8.107 (GND), U8.108 (GND), U8.109 (GND), U8.110 (GND), U8.111 (GND), U8.112 (GND), U8.113 (GND); also elsewhere on the board
unnamed: JP6.1 (A), R31.2
unnamed: JP6.2 (B), JP7.1 (A), U8.10 (ENABLE)
unnamed: JP7.2 (B), Q3.3 (D), R32.2
unnamed: Q2.3 (D), Q3.1 (G), R30.1
unnamed: C33.1, U8.24 (DEC0)
unnamed: C34.1, R35.2, U8.9 (~RESET)
SIM_1V8: U8.19 (SIM_1V8); also elsewhere on the board
VDD_GPIO: C31.1, C32.1, U8.65 (VDD_GPIO); also elsewhere on the board
VSYS: C27.1, C28.1, C29.1, L7.1; also elsewhere on the board

Notes on the sheet:
[nRF9151]

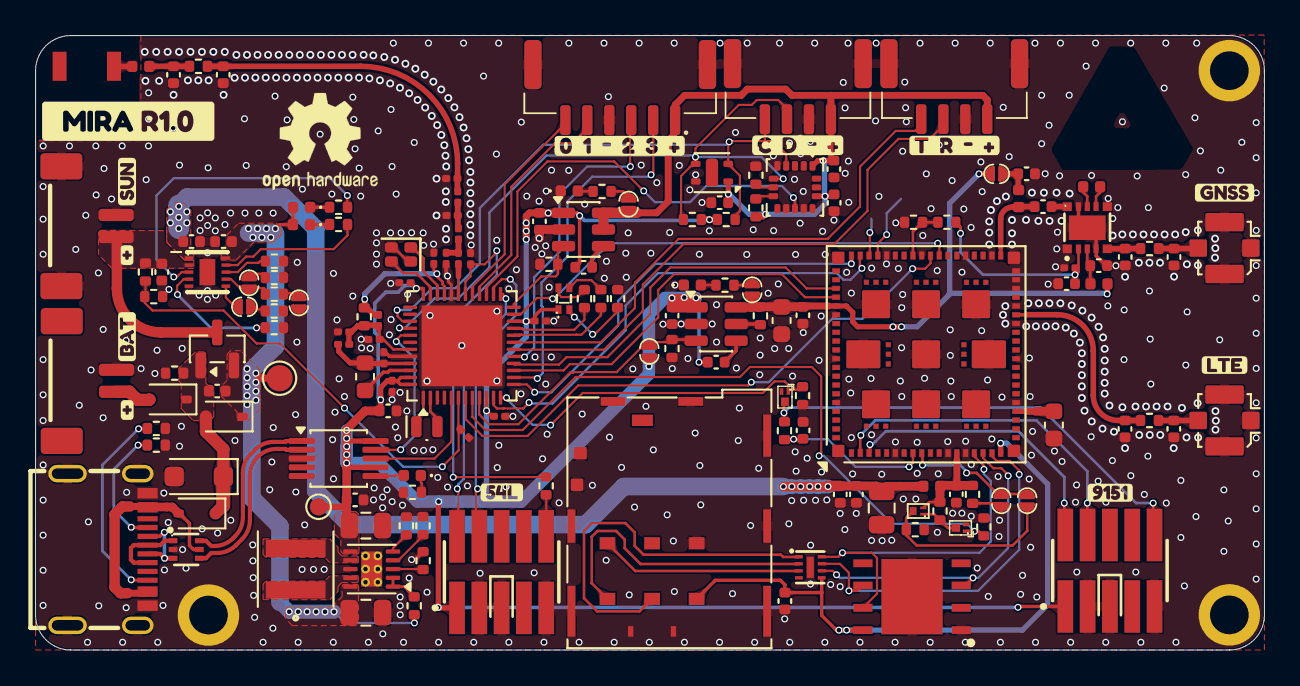
[picture p15: board MIRA.kicad_pcb from above]

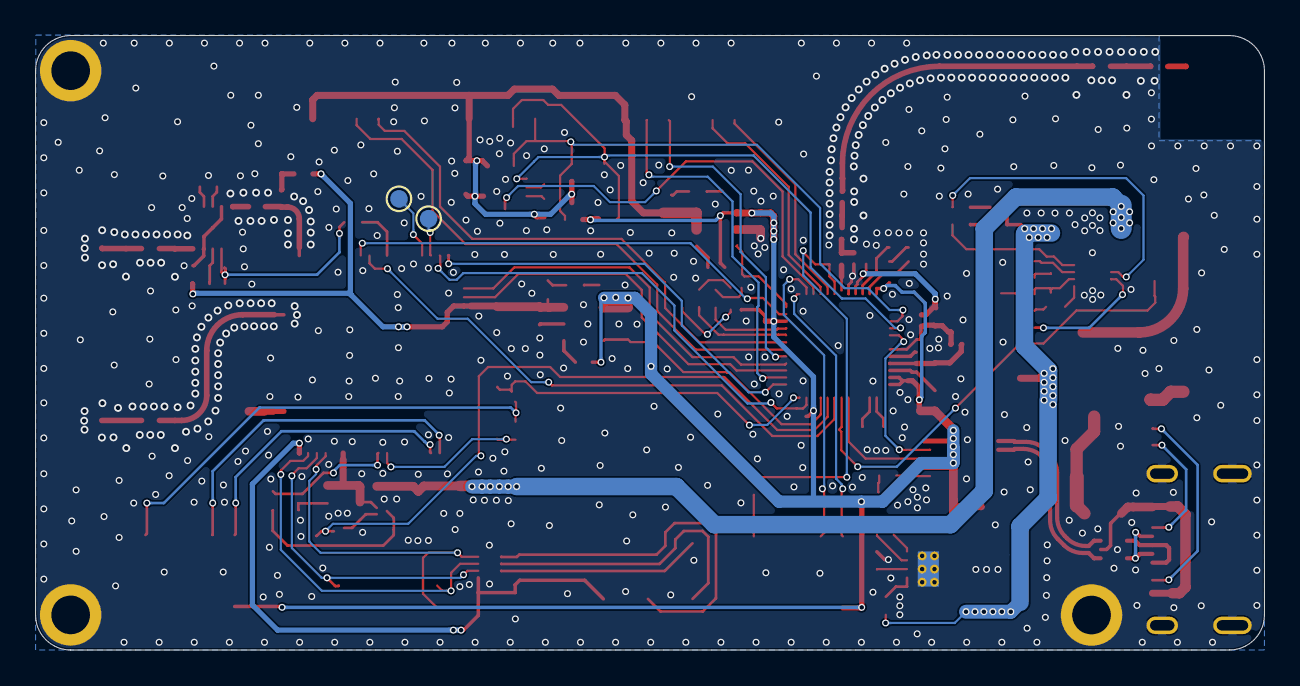
[picture p16: board MIRA.kicad_pcb from below]

Board: 4 copper layers, 70.0 x 35.0 mm, 171 parts (2 on the bottom side), 120 nets.

Other parts of the board:
kobee-studio-6ADCD3D5, kobee-studio-6ADCD3E6, kobee-studio-6ADCD3FA, kobee-studio-6ADCD3FA#2, kobee-studio-6ADCD5CB, kobee-studio-6ADCD5DB, kobee-studio-6ADCD7BB, kobee-studio-6ADCD7DD, kobee-studio-6ADCD390, kobee-studio-6ADCD606, kobee-studio-6ADCD613, kobee-studio-6ADCD849: Kobee Studio; kobee-studio-6ADCD390
