piecol/MIRA/(commit log)

2026-10-24 more codes lcsc
    [MIRA-CuBottom.gbr, MIRA-CuIn1.gbr, MIRA-CuIn2.gbr, MIRA-CuTop.gbr, MIRA-EdgeCuts.gbr, MIRA-MaskBottom.gbr, MIRA-MaskTop.gbr, MIRA-NPTH.drl]
2026-10-25 prod files
    [IO.kicad_sch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]
